Denhart/uniProject9-10/scripts/ff2correlation/README.md

# Files

## cst\_top, cst\_side
- Antenna: ilvonen2014design
- Top and side antenna
- Frequency: 870 MHz
- Expected correlation: 0.23578
