Denhart/uniProject9-10/rep/sec/analysis/requirements_spec.tex

\chapter{Requirements Specification}
\label{cha:reqspec}

\begin{aautop}
    The requirement specification sums up requirements, definitions, and guidelines for designing the antennas in the following chapters. Not all the requirement are hard requirements but guidelines for the design process.
\end{aautop}

\section{Functional Requirements}
\noindent
\begin{tabularx}{\linewidth}{|l|X|}
    \hline
    ID & Requirement \\
    \hline
    \freq{dualband} & The antenna system must consist of two single-feed dual-band antennas covering the bands described in Requirement~\sreqref{fbands}. \\
    \freq{updownlink} & Each antenna must cover both uplink and downlink at the same time for each required LTE band.\\
    % \freq{usereffect} & Must be able to re-tune any detuning due to user effects. \\ % ???? HAHA
    \freq{matching} & Must have a simple matching network, containing a variable capacitor for tuning inside the specified bands.\\
    \freq{wispry} & Must use a WiSpry WS1040 MEMS variable capacitor chip in the matching network.\\
    \hline
\end{tabularx}

\section{Specific Requirements}
\noindent 
\begin{tabularx}{\linewidth}{|l|l|X|}
    \hline
    ID & Specification & Requirement \\
    \hline
    \sreq{fbands} & Frequency bands\slash tunable range & \num{700}--\SI{960}{MHz}, \num{1710}--\SI{2170}{MHz}, \num{2300}--\SI{2400}{MHz}, \num{2550}--\SI{2650}{MHz} \\
    \sreq{bandwidthlow} & Minimum tunable bandwidth (\num{700}--\SI{960}{MHz}) & \SI{80}{MHz} (band 8) \\
    \sreq{bandwidthhigh} & Minimum tunable bandwidth (\num{1710}--\SI{2650}{MHz}) & \SI{720}{MHz} (band 15) \\
    \sreq{physdim} & Physical dimensions & External: $70\times140\times7$\,\si{mm\cubed}, PCB: $55\times120\times1.6$\,\si{mm\cubed} (FR-4)\\
    \sreq{copper} & Ground plane copper thickness & \SI{0.035}{mm} \\
    \sreq{retloss} & In-band return loss (impedance bandwidth) & $\text{RL} > \SI{6}{dB}$\\
    \sreq{correlation} & In-band correlation between antenna elements (correlation bandwidth) & $\rho_e < 0.5$\\
    \sreq{efficiency} & In-band total efficiency in free-space (efficiency bandwidth)  & $>\SI{50}{\%}$ \\
    \sreq{sar} & Maximum SAR & \SI{2}{W\per kg} averaged over \SI{10}{g} of tissue\\
    \sreq{tunable} & Tunable capacitor range (WS1040)& \SI{0.3}{pF} to \SI{2.9}{pF} in steps of \SI{0.2}{pF} (\SI{0.1}{pF} minimum)  \\
    \sreq{ltepower} & Reference power level  & \SI{23}{dBm} (\SI{0.2}{W})\\
    \hline
\end{tabularx}

\begin{aautail}
In this chapter, the functional and specific requirements for the antennas have been listed. The next chapter contains a test specification for the above specific requirements, describing how each requirement will be tested. 
\end{aautail}
