Denhart/uniProject9-10/pres/pres.tex

\documentclass[t]{beamer}
\usepackage[utf8]{inputenc}
\usepackage{soul}
\usepackage{tabularx}
\usepackage{booktabs}
\usepackage{tikz}
\usepackage{ulem}
\usepackage[per-mode = symbol,detect-all=true]{siunitx}
\sisetup{
    output-decimal-marker = {.},
    output-exponent-marker=\textsc{e}, 
    % round-mode=places,
    output-complex-root=j, 
    % unit-color=blue,
    % scientific-notation = engineering
}
\DeclareSIUnit[number-unit-product = \,]{\permil}{\textperthousand}
\usetheme{noergaard}
\newcommand{\hi}[1]{{\textcolor{themecolor}{\bfseries{#1}}}}

\definecolor{bb}{rgb}{0.0, 0.0, 1.0}
\definecolor{gg}{rgb}{0.0, 0.5, 0.0}
\definecolor{rr}{rgb}{1.0, 0.0, 0.0}
\definecolor{cc}{rgb}{0.0, 0.75, 0.75}
\definecolor{mm}{rgb}{0.75, 0.0, 0.75}
\definecolor{yy}{rgb}{0.75, 0.75, 0.0}
\definecolor{kk}{rgb}{0.0, 0.0, 0.0}

\newcounter{funcreqcnt}
\newcounter{specreqcnt}
\newcommand{\freq}[1]{ \refstepcounter{funcreqcnt}\label{#1} F\arabic{funcreqcnt} }
\newcommand{\sreq}[1]{ \refstepcounter{specreqcnt}\label{#1} S\arabic{specreqcnt} }
\newcommand{\freqref}[1]{F\ref{#1}}
\newcommand{\sreqref}[1]{S\ref{#1}}

\newcolumntype{R}{>{\raggedleft\arraybackslash}X}
\newcolumntype{C}{>{\centering\arraybackslash}X}
\newcolumntype{k}[1]{>{\centering\let\newline\\\arraybackslash\hspace{0pt}}p{#1}}

\title{\hi{Tunable Antennas for Handsets Supporting MIMO}}
\author{
    \hi{Group 951/1051}\\
    Henrik A.\ Vesterager\\
    Søren B.\ Nørgaard\\
    Lasse Thomsen\\[1em]
    Wireless Communication Systems\\
    Dept.\ of Electronic Systems, Aalborg University
}
\date{June 24, 2016}

\begin{document}
{%
    \setbeamertemplate{headline}{}
    \frame{\titlepage}
}

\begin{frame}
    \frametitle{Overview}
    \ \\
    \begin{minipage}{\linewidth}
        \tableofcontents
    \end{minipage}
\end{frame}

% \input{sec/exampleslide}
\input{sec/henrik}
\input{sec/soren}
\input{sec/lasse}
\end{document}
