Denhart/uniProject9-10/pres/sec/lasse.tex

\section[Ground Clearance]{Ground Clearance (Lasse)}
\def\legendfooter{\scriptsize{Upper: Top antenna. Lower: Side antenna. \textcolor{bb}{Monopole Sim}, \textcolor{gg}{Monopole Meas}, \textcolor{rr}{Triangle-Feed Meas}, Frequency in MHz.}}
\def\emptyline{\textcolor{white}{Empty}}

\begin{frame}[fragile]
  \frametitle{Ground Clearance}
  \begin{columns}[onlytextwidth,t]
    \column{0.49\linewidth}
      \begin{itemize}
      \item Triangle-Feed antenna measured on tuner PCB.
      \item More realizable antenna design in a mobile phone.
      \item One way of minimizing the antenna design.
      \item \SI{10}{mm} to \SI{5}{mm} ground clearance simulation.
      \item Minimized and simplified monopole design.
      \item Non-resonant design (monopole structure)
      \end{itemize}
    \column{0.49\linewidth}
    \begin{center}
      
    \end{center}
  \end{columns}
\end{frame}

\begin{frame}
  \frametitle{Ground Clearance}
    \begin{center}
      

    \end{center}
      \begin{itemize}
      \item Significant bandwidth and efficiency drop from \SI{5}{mm} to \SI{4}{mm}.
      \end{itemize}
\end{frame}

\section[Tuner PCB]{Tuner PCB (Lasse)}
\begin{frame}[fragile]
    \frametitle{Tuner PCB with MEMS Tuner}
\begin{center}
            
\end{center}
\begin{itemize}
\item Use previously made Tuner PCB -- save time.
\end{itemize}
\end{frame}

\begin{frame}
  \frametitle{Tuner PCB Results}
  \begin{itemize}
  \item Problems with detuning in the high frequencies.
  \end{itemize}
  \begin{center}
    
     \\
    
    
  \end{center}
\legendfooter
\end{frame}

\begin{frame}[fragile]
    \frametitle{Tuner PCB -- Modified Design}
    \begin{columns}[onlytextwidth,t]
        \column{0.49\linewidth}
          \begin{itemize}
          \item Adding a higher resonance to counteract the detuning.
          \item Two arms added in the available space. 
          \item Ground clearance \SI{2.5}{mm}.
          \end{itemize}
        \column{0.49\linewidth}
        \begin{center}
            
            
        \end{center}
        Tuner PCB with the modified monopole.
    \end{columns}
\end{frame}
\def\legendfooter{\scriptsize{Upper: Top antenna. Lower: Side antenna. \textcolor{bb}{Monopole Sim}, \textcolor{gg}{Monopole Meas}, Frequency in MHz.}}
\def\emptyline{\textcolor{white}{Empty}}

\begin{frame}
  \frametitle{Modified Monopole Results.}
\begin{center}
    
     \\
    
    
\end{center}
\vspace{-3mm}
      \begin{itemize}
      \item Final results -- something on the PCB radiating.
      \end{itemize}
\legendfooter
\end{frame}
\def\legendfooter{\scriptsize{Upper: Top antenna. Lower: Side antenna. \textcolor{bb}{Monopole without cap}, \textcolor{gg}{Monopole with cap}, Frequency in MHz.}}
\def\emptyline{\textcolor{white}{Empty}}

\begin{frame}
  \frametitle{Tuner PCB}
  \begin{itemize}
  \item With and without transmission line shunt capacitor.
  \item ``Finger sweep'' -- add capacitance.
  \end{itemize}
\begin{center}
    
\end{center}
\begin{itemize}
\item Increase in bandwidth in the high band.
\item Most significant for S11 but is also the case for S22. 
\end{itemize}
\legendfooter
\end{frame}

\section[Conclusion]{Conclusion (Lasse)}
\begin{frame}
  \begin{block}{Conclusion}
    \begin{itemize}
    \item \textbf{Three preliminary designs.}
    \item \textbf{Two designs on the tuner PCB.}
    \item Modified \SI{2.5}{mm} ground clearance design.
    \item Three \textbf{promising prototype results} (minimized antenna).
    \item Problems with the resonance in the higher frequencies.
    \item Low correlation on the high band -- \textbf{MIMO support in the high band}.
    \end{itemize}
  \end{block}
\vspace{-3mm}
  \begin{block}{Future Work}
    \begin{itemize}
    \item Simulation of Tuner PCB.
    \item New Tuner PCB.
    \item Modified monopole not necessary. 
    \item Different \SI{5}{mm} antenna designs.
    \item Two different designs on the PCB.
    \item Measure correlation -- simplified simulations.
    \end{itemize}
  \end{block}
\end{frame}

\begin{frame}
  \frametitle{Demo}
  \begin{columns}[onlytextwidth,t]
    \column{0.49\linewidth}
    \begin{itemize}
    \item S-Parameter sweep with the digitally MEMS tuner.
    \item Sweep the capacitance outside Satimo.
    \item UART over optical fiber to RFFE.
    \item No changes with the RFFE adaptor board + battery.
    \end{itemize}
    \column{0.49\linewidth}
        \begin{center}
            
        \end{center}
    \end{columns}
\end{frame}
