Denhart/uniProject9-10/pres/sec/soren.tex

\section[User Effects]{User Effects (Søren)}
% Illustration of setup/positions on slide 1
% One slide for each:
    % All S11 on slide 2 
    % All S22 on slide 3
    % All S21 on slide 4
    % All efficiency on slide 5
    % All correlation on slide 6
    % All SAR on slide 7 (only one figure)
% For each slide, three figures/subplot (for each design)
    % Blue (freespace[0]), alpha 0.5 (min(freespace))
    % Green (data[0]), alpha 0.5 (min(data))
    % Red (play[0]), alpha 0.5 (min(play))
    % Cyan (talk[0]), alpha 0.5 (min(talk))

\def\legendfooter{\scriptsize{(1) Monopole (2) Triangle-feed (3) Dual-feed. \textcolor{bb}{Free-space}, \textcolor{gg}{Data}, \textcolor{rr}{Play}, \textcolor{cc}{Talk}. Frequency in MHz.}}
\def\emptyline{\textcolor{white}{Empty}}
\begin{frame}
    \frametitle{User Effects}
    \begin{columns}[onlytextwidth,T]
        \column{0.49\linewidth}
        Color codes: \vspace{0pt}
        \begin{tabular}{m{1in}m{3in}}
            \rule{0in}{0.3in} & \textcolor{bb}{Free space}\\
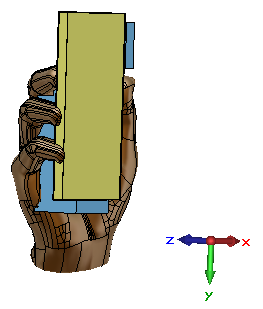
[picture p2: pres/img/soren/ue/usereff_onehand.PNG]
            \centering & \textcolor{gg}{Data mode} \\
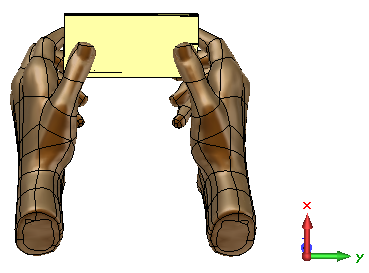
[picture p3: pres/img/soren/ue/usereff_twohand.PNG]
            \centering & \textcolor{rr}{Play mode} \\
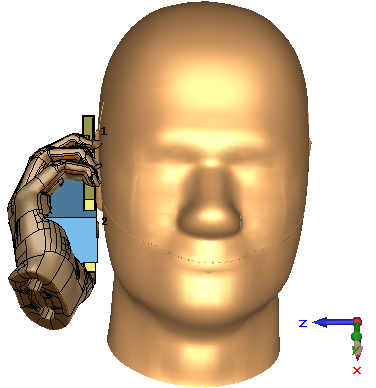
[picture p4: pres/img/soren/ue/usereff_headhand.PNG]
            \centering& \textcolor{cc}{Talk mode}\\
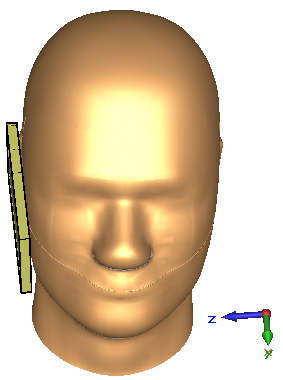
[picture p5: pres/img/soren/ue/usereff_sar.PNG]
            \centering     & SAR
        \end{tabular}

        \column{0.49\linewidth}
        Goal:
        \begin{itemize}
            \item Find the most stable design.
            \item Preserves bandwidth in use cases.
        \end{itemize}

        Plots:
        \begin{itemize}
            \item $S_{11}$, $S_{22}$, efficiency, correlation.
            \item All SAR $<\SI{2}{W/kg}$ @ \SI{10}{g} averaging.
            \item Isolation not shown. See report.
        \end{itemize}
        

        Spoiler:
        \begin{itemize}
            \item Design 2 (triangle-feed) is better.
        \end{itemize}
    \end{columns}
\end{frame}

\begin{frame}
    \frametitle{User Effects -- S11, minimum over tunable range}
    % \emptyline
    Design 2 is generally is better matched.
    \begin{center}
        \\
        \\
        
    \end{center}
    \legendfooter
\end{frame}

\begin{frame}
    \frametitle{User Effects -- S22, minimum over tunable range}
    % \emptyline
    Detuning. Design 2 is better matched.
    \begin{center}
        \\
        \\
        
    \end{center}
    \legendfooter
\end{frame}

\begin{frame}
    \frametitle{User Effects -- Total efficiency, minimum over tunable range (top)}
    % \emptyline
    \textit{Ideal components}. Talk mode is the worst.
    \begin{center}
        \\
        \\
        
    \end{center}
    \legendfooter
\end{frame}

\begin{frame}
    \frametitle{User Effects -- Total efficiency, minimum over tunable range (side)}
    \emptyline
    \begin{center}
        \\
        \\
        
    \end{center}
    \legendfooter
\end{frame}

\begin{frame}
    \frametitle{User Effects -- Correlation, minimum over tunable range (tuning top)}
    Highest: Free-space, talk mode. Winner $=$ design 3.
    % \emptyline
    \begin{center}
        \\
        \\
        
    \end{center}
    \legendfooter
\end{frame}

\begin{frame}
    \frametitle{User Effects -- Correlation, minimum over tunable range (tuning side)}
    Lower than tuning top.
    \emptyline
    \begin{center}
        \\
        \\
        
    \end{center}
    \legendfooter
\end{frame}

\begin{frame}
    \frametitle{User Effects -- Preliminary Conclusion}
    \begin{tabular}{m{0.4in}m{4in}}
        \rule{0pt}{0.9in} & 
            Design 2 -- triangle-feed
            \begin{itemize}
                \item Better efficiency and impedance bandwidth.
                \item High free-space correlation in low band. 
            \end{itemize}
            \\
        \rule{0pt}{0.9in} & 
            Design 3 -- dual-feed
            \begin{itemize}
                \item More fluctuating than design 2.
                \item Still good bandwidth/efficiency.
            \end{itemize}
            \\
        \rule{0pt}{0.9in} & 
            Design 1 -- monopole
            \begin{itemize}
                \item Very sensitive to user effects.
                \item Low efficiency and impedance bandwidth.
            \end{itemize}
    \end{tabular}
\end{frame}

\section[Prototypes]{Prototypes (Søren)}
\begin{frame}
    \frametitle{Prototypes}
    \begin{columns}[onlytextwidth,T]
        \vspace{0em}
        \column{0.49\linewidth}
        \begin{tabular}{m{0.3in}m{1.4in}}
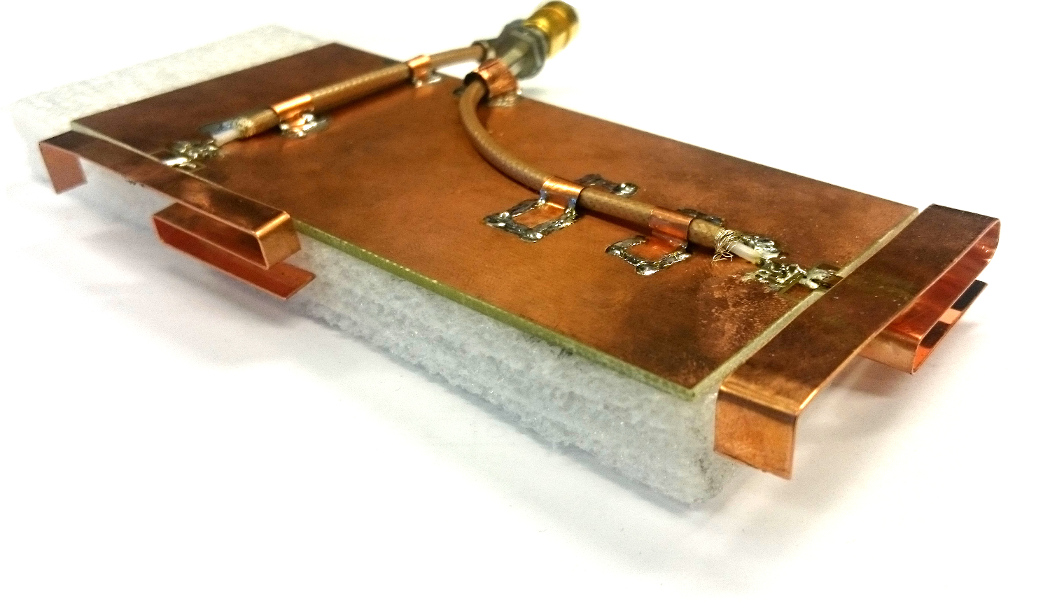
[picture p6: pres/img/soren/proto/design1.jpg]
             (1) & \\
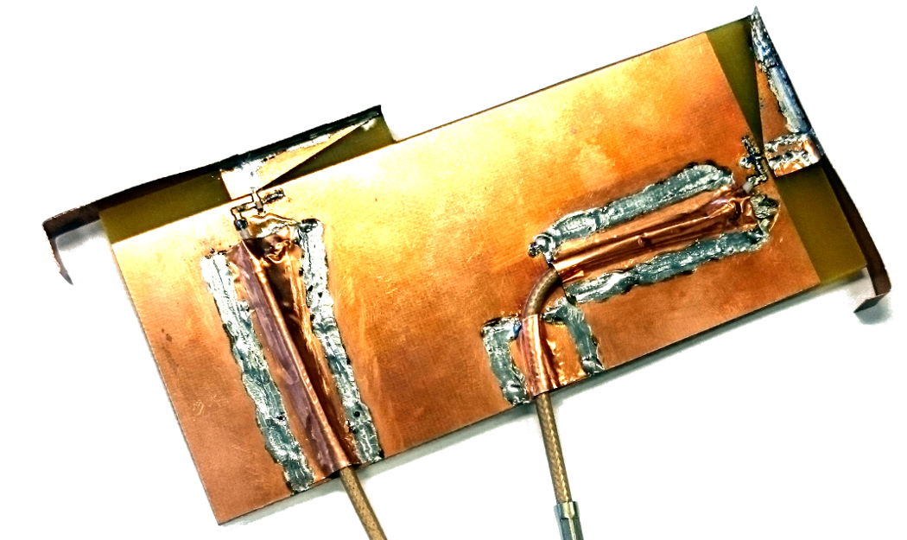
[picture p7: pres/img/soren/proto/design2.jpg]
             (2) & \\
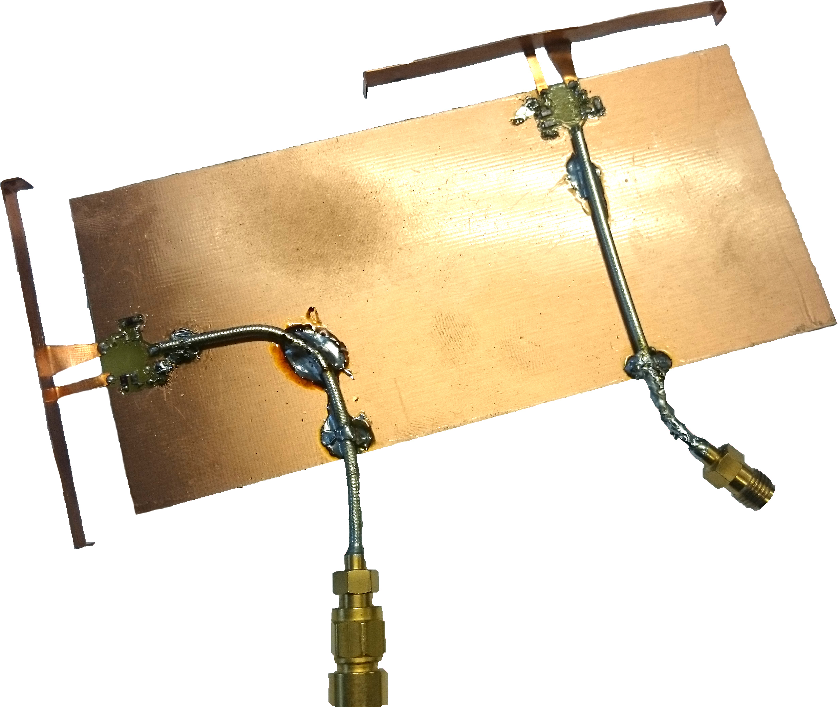
[picture p8: pres/img/soren/proto/design3.jpg]
             (3) & 
        \end{tabular}

        \column{0.49\linewidth}
        Goal:
        \begin{itemize}
            \item Find most realizable design.
            \item Verify simulation results -- useful design in real life?
        \end{itemize}

        Plots:
        \begin{itemize}
            \item $S_{11}$, $S_{22}$, efficiency.
            \item Isolation not shown. See report.
        \end{itemize}

        Spoiler:
        \begin{itemize}
            \item Design 2 (triangle-feed) is better.
        \end{itemize}
    \end{columns}
\end{frame}

\def\legendfooter{\scriptsize{Upper: Top antenna. Lower: Side antenna. Frequency in MHz.}}
\begin{frame}
    \frametitle{Prototype 1 -- Monopole}
    High band moves a lot during tuning.
    % \emptyline
    \begin{center}
        
        \\
        
        
    \end{center}
    \legendfooter
\end{frame}

\begin{frame}
    \frametitle{Prototype 2 -- Triangle-feed}
    \textcolor{gg}{High bandwidth!} High band stable over multiple capacitances.
    % \emptyline
    \begin{center}
        
        \\
        
        
    \end{center}
    \legendfooter
\end{frame}

\begin{frame}
    \frametitle{Prototype 3 -- Dual-feed}
    OK efficiency. Side antenna -- good but not tunable.
    % \emptyline
    \begin{center}
        
        \\
        
        
    \end{center}
    \legendfooter
\end{frame}

\begin{frame}
    \frametitle{Prototypes -- Preliminary Conclusion}
    \begin{tabular}{m{0.4in}m{4in}}
        \rule{0pt}{0.9in} & 
            Design 2 -- triangle-feed.
            \begin{itemize}
                \item Covers all bands at $C_{\text{low}}$.
                \item Preserves higher efficiency when tuned.
                \item \textit{Moved to tuner PCB}.
            \end{itemize}
            \\
        \rule{0pt}{0.9in} & 
            Design 3 -- dual-feed
            \begin{itemize}
                \item Top antenna good in most bands.
                \item Side antenna not tunable but good.
                \item Matching network $\neq$ tuner PCB.
            \end{itemize}
            \\
        \rule{0pt}{0.9in} & 
            Design 1 -- monopole
            \begin{itemize}
                \item Covers low bands OK.
                \item Low efficiency when tuned.
            \end{itemize}
    \end{tabular}
\end{frame}
