Denhart/uniProject9-10/rep/set/frontpage.tex

\thispagestyle{empty}
\newgeometry{top=1.7cm, bottom=1.7cm, left=1.7cm, right=1.7cm}
\noindent%
\begin{tabular}{@{}p{\textwidth}@{}}
    \rule{\linewidth}{2mm}\vspace{1.5cm}
    \vspace*{-15mm}
    \begin{flushleft}
        \linespread{0.7}
        \fontsize{40}{56}
        \usefont{T1}{phv}{b}{}
        \selectfont
        Tunable Antennas for Handsets Supporting MIMO
    \end{flushleft} \\[5mm] 
    \raggedright{
        \fontsize{24}{36}\usefont{T1}{phv}{}{}\selectfont
        June 2016\\ \vspace*{1mm}
    }
    \rule{\linewidth}{.7mm}
\end{tabular}
\vspace{1cm} %Removed to make it one page
\begin{flushleft}
  {\LARGE\usefont{T1}{phv}{b}{}\selectfont
      Group 951/1051%Insert your group name or real names here
  }\\
  \vspace{0.2cm}
  {\large\usefont{T1}{phv}{}{}\selectfont
      Master Thesis %Insert document type (e.g., Project Report)
  }
\end{flushleft}
\begin{center}
    % \includegraphics[scale=.7]{img/frontpage}
\end{center}
\vfill
\begin{flushleft}\usefont{T1}{phv}{}{}\selectfont
  Aalborg University\\
  Department of Electronic Systems\\
  Wireless Communication Systems\\
  Fredrik Bajers Vej 7\\
  DK-9220 Aalborg
\end{flushleft}
\restoregeometry
