Denhart/uniProject9-10/rep/sec/tech_sol/sol_3_usereff.tex

\section{Dual-Feed Antenna}
In this section, the results from Section~\ref{sec:tech_sol_ant3} will be repeated, having the phone in data mode, play mode, and talk mode. Furthermore, the maximum SAR value, recorded in the users head, will be simulated. The antenna positions, for each use case, are shown in Figure~\ref{fig:ant3_positions}.

\begin{figure}[htbp]
    \centering
    \begin{subfigure}[b]{0.24\linewidth}
        \centering
        
        \caption{Data mode.}
    \end{subfigure}
    \begin{subfigure}[b]{0.24\linewidth}
        \centering
        
        \caption{Play mode.}
    \end{subfigure}
    \begin{subfigure}[b]{0.24\linewidth}
        \centering
        
        \caption{Talk mode.}
    \end{subfigure}
    \begin{subfigure}[b]{0.24\linewidth}
        \centering
        
        \caption{SAR.}
    \end{subfigure}
    \caption{Antenna position for each user effect simulation.}
    \label{fig:ant3_positions}
\end{figure}

\FloatBarrier
\subsection{Data Mode}
%%
Figure~\ref{fig:ant3_sparam_data} shows the $S$-parameters with the tunable capacitors set to their maxima. As such, both the top and side antennas have been tuned down to the lowest possible frequency. It is seen that the top antenna covers most of the band from \SI{700}{MHz} to \SI{960}{MHz} with a return loss above \SI{6}{dB}. The side antenna is, however, very narrowband and must be tuned in order to cover all the low bands. It is also seen that the side antenna does not cover the entire high band when tuned down to the lowest capacitor value. 

%%
The $S$-parameters, when sweeping the tunable capacitors, are shown in Figure~\ref{fig:ant3_sparam_sweep_data}. The maximum impedance-bandwidths are summed up in Table~\ref{tab:bw_sol3data}. From this, it is again clear that only the top antenna is able to cover the high end of the low band. Both antennas are able to cover the entire high band at \SI{6}{dB} return loss, except for a drop of \SI{1}{dB} at \SI{2600}{MHz} to \SI{2650}{MHz} for the top antenna.

%%
The correlation between the antennas, when sweeping the tunable capacitors, are shown in Figure~\ref{fig:corr_sol3_data}. The correlation is, for frequencies above \SI{700}{MHz}, below 0.4 when sweeping the top and side antenna. For the high band, the correlation is significantly lower, which is also to be expected. The correlation has dropped a lot from the free-space simulation in Figure~\ref{fig:corr_sol3}.

%%
The efficiencies for each antenna, when sweeping the tuning capacitors, are shown in Figure~\ref{fig:eff_sol3data}. It is seen that the efficiency, generally, has decreased from the free-space simulation in Chapter~\ref{cha:nousersim}. At \SI{-3}{dB} efficiency, there is no bandwidth left. At \SI{-6}{dB} all bands are covered. The efficiency in the high band is generally higher than in the low band.

\begin{figure}[htbp]
    \centering
    
    \caption{The antenna in data mode. $S$-parameters with both tuning capacitors fixed at \SI{2.9}{pF}.}
    \label{fig:ant3_sparam_data}
\end{figure}

\begin{table}[htbp]
    \centering
    \begin{tabular}{|l|l|r|r|r|}
        \hline
        Antenna & Band & Start [MHz] & Stop [MHz] & Bandwidth [MHz] \\
        \hline
        Top     & Low  & 713         & 963       & 250 \\
        Side    & Low  & 717         & 765        & 48  \\
        \hline
        Top     & High & 1635         & 2537       & 902 \\
        Side    & High & 1430        & 2582       & 1152 \\
        \hline
    \end{tabular}
    \caption{The antenna in data mode. Maximum bandwidth obtained in the low and high band for the top and the side antenna, respectively.}
    \label{tab:bw_sol3data}
\end{table}

\begin{figure}[htbp]
   \begin{subfigure}[b]{0.49\linewidth}
        \centering
        
        \caption{$S_{11}$, sweeping $C_{l3}$ and fixing $s\_C_{h1}$.}
    \end{subfigure}
    \hfill
    \begin{subfigure}[b]{0.49\linewidth}
        \centering
        
        \caption{$S_{22}$, sweeping $C_{l3}$ and fixing $s\_C_{h1}$.}
    \end{subfigure}
    \\
    \begin{subfigure}[b]{0.49\linewidth}
        \centering
        
        \caption{$S_{21}$, sweeping $C_{l3}$ and fixing $s\_C_{h1}$.}
    \end{subfigure}
    \hfill
    \begin{subfigure}[b]{0.49\linewidth}
        \centering
        
        \caption{$S_{21}$, sweeping $s\_C_{h1}$ and fixing $C_{l3}$.}
    \end{subfigure}
    \caption{The antenna in data mode. $S$-parameter sweep for tuning the shunt capacitor of each antenna, $C_{l3}$ and $s\_C_{h1}$ for port 1 and 2, respectively. Port 1 is the top antenna and port 2 is the side antenna.}
    \label{fig:ant3_sparam_sweep_data}
\end{figure}

% Correlation
\begin{figure}[htbp]
    \centering
    \begin{subfigure}{0.49\linewidth}
        
        \caption{Sweeping $C_{l3}$ and fixing $s\_C_{h1}$.}
    \end{subfigure}
    \hfill
    \begin{subfigure}{0.49\linewidth}
        
        \caption{Sweeping $s\_C_{h1}$ and fixing $C_{l3}$.}
    \end{subfigure}
    \caption{The antenna in data mode. Correlation between antennas when sweeping the tuning capacitors. Here, $C_{l3}$ and $s\_C_{h1}$ are the tuning capacitor for the top and side antenna, respectively.}
    \label{fig:corr_sol3_data}
\end{figure}

% Efficiency
\begin{figure}[htbp]
    \centering
    \begin{subfigure}{0.49\linewidth}
        \centering
        
        \caption{Top antenna. Sweeping $C_{l3}$, fixing $s\_C_{h1}$.}
    \end{subfigure}
    \hfill
    \begin{subfigure}{0.49\linewidth}
        \centering
        
        \caption{Side antenna. Sweeping $s\_C_{h1}$, fixing $C_{l3}$.}
    \end{subfigure}
    \caption{The antenna in data mode. Efficiency for each antenna when sweeping the tuning capacitors. Here, $C_{l3}$ and $s\_C_{h1}$ are the tuning capacitor for the top and side antenna, respectively.}
    \label{fig:eff_sol3data}
\end{figure}

\FloatBarrier
\subsection{Play Mode}
%%
Figure~\ref{fig:ant3_sparam_play} shows the $S$-parameters with the tunable capacitors set to their maxima. As such, both the top and side antennas have been tuned down to the lowest possible frequency. It is seen that the top antenna covers most of the band from \SI{700}{MHz} to \SI{960}{MHz} with a return loss above \SI{4}{dB}. The side antenna is, however, very narrowband, and must be tuned in order to cover all the low bands. It is also seen that the side antenna does not cover the entire high band when tuned down to the lowest. 

%%
The $S$-parameters, when sweeping the tunable capacitors, are shown in Figure~\ref{fig:ant3_sparam_sweep_play}. The maximum impedance bandwidths are summed up in Table~\ref{tab:bw_sol3data}. From this, it is again clear that only the top antenna is able to cover the high end of the low band. Both antennas are be able to cover the entire high band at \SI{4}{dB} return loss.

%%
The correlation between the antennas, when sweeping the tunable capacitors, are shown in Figure~\ref{fig:corr_sol3_play}. The correlation is, for frequencies above \SI{700}{MHz}, below 0.4 when sweeping the top and side antenna. For the high band, the correlation is significantly lower. Again, the correlation has dropped a lot from the free-space simulation in Figure~\ref{fig:corr_sol3}.

%%
The efficiencies for each antenna, when sweeping the tuning capacitors, are shown in Figure~\ref{fig:eff_sol3play}. It is seen that the efficiency, generally, has decreased from the free-space simulation in Chapter~\ref{cha:nousersim} and is also lower than the data mode. At \SI{-3}{dB} efficiency, there is no bandwidth left. At \SI{-6}{dB} most of the bands are covered.

\begin{figure}[htbp]
    \centering
    
    \caption{The antenna in play mode. $S$-parameters with both tuning capacitors fixed at \SI{2.9}{pF}.}
    \label{fig:ant3_sparam_play}
\end{figure}

\begin{table}[htbp]
    \centering
    \begin{tabular}{|l|l|r|r|r|}
        \hline
        Antenna & Band & Start [MHz] & Stop [MHz] & Bandwidth [MHz] \\
        \hline
        Top     & Low  & 690         & 791        & 101  \\
        Side    & Low  & 780         & 803        & 23   \\
        \hline
        Top     & High & 1676        & 2579       & 903 \\
        Side    & High & 1341        & 1919       & 578 \\
        \hline
    \end{tabular}
    \caption{The antenna in play mode. Maximum bandwidth obtained in the low and high band for the top and the side antenna, respectively. The bandwidth for the antennas high band is ignoring the rise above \SI{-6}{dB} in the middle of the band.}
    \label{tab:bw_sol3play}
\end{table}

\begin{figure}[htbp]
   \begin{subfigure}[b]{0.49\linewidth}
        \centering
        
        \caption{$S_{11}$, sweeping $C_{l3}$ and fixing $s\_C_{h1}$.}
    \end{subfigure}
    \hfill
    \begin{subfigure}[b]{0.49\linewidth}
        \centering
        
        \caption{$S_{22}$, sweeping $C_{l3}$ and fixing $s\_C_{h1}$.}
    \end{subfigure}
    \\
    \begin{subfigure}[b]{0.49\linewidth}
        \centering
        
        \caption{$S_{21}$, sweeping $C_{l3}$ and fixing $s\_C_{h1}$.}
    \end{subfigure}
    \hfill
    \begin{subfigure}[b]{0.49\linewidth}
        \centering
        
        \caption{$S_{21}$, sweeping $s\_C_{h1}$ and fixing $C_{l3}$.}
    \end{subfigure}
    \caption{The antenna in play mode. Parameter sweep for tuning the shunt capacitor of each antenna, $C_{l3}$ and $s\_C_{h1}$ for port 1 and 2, respectively. Port 1 is the top antenna and port 2 is the side antenna.}
    \label{fig:ant3_sparam_sweep_play}
\end{figure}

% Correlation
\begin{figure}[htbp]
    \centering
    \begin{subfigure}{0.49\linewidth}
        
        \caption{Sweeping $C_{l3}$ and fixing $s\_C_{h1}$.}
    \end{subfigure}
    \hfill
    \begin{subfigure}{0.49\linewidth}
        
        \caption{Sweeping $s\_C_{h1}$ and fixing $C_{l3}$.}
    \end{subfigure}
    \caption{The antenna in play mode. Correlation between antennas when sweeping tuning the capacitors. Here, $C_{l3}$ and $s\_C_{h1}$ are the tuning capacitor for the top and side antenna, respectively.}
    \label{fig:corr_sol3_play}
\end{figure}

% Efficiency
\begin{figure}[htbp]
    \centering
    \begin{subfigure}{0.49\linewidth}
        \centering
        
        \caption{Top antenna. Sweeping $C_{l3}$, fixing $s\_C_{h1}$.}
    \end{subfigure}
    \hfill
    \begin{subfigure}{0.49\linewidth}
        \centering
        
        \caption{Side antenna. Sweeping $s\_C_{h1}$, fixing $C_{l3}$.}
    \end{subfigure}
    \caption{The antenna in play mode. Efficiency for each antenna when sweeping the tuning capacitors. Here, $C_{l3}$ and $s\_C_{h1}$ are the tuning capacitor for the top and side antenna, respectively.}
    \label{fig:eff_sol3play}
\end{figure}

\FloatBarrier
\subsection{Talk Mode}
%%
Figure~\ref{fig:ant3_sparam_talk} shows the $S$-parameters with the tunable capacitors set to their maxima. As such, both the top and side antennas have been tuned down to the lowest possible frequency. It is seen that the top antenna covers most of the band from \SI{700}{MHz} to \SI{960}{MHz}, with a return loss above \SI{6}{dB}. The side antenna is, however, very narrowband, and must be tuned in order to cover all the low bands. It is also seen that the side antenna does not cover the entire high band when tuned down to the lowest. 

%%
The $S$-parameters, when sweeping the tunable capacitors, are shown in Figure~\ref{fig:ant3_sparam_sweep_play}. The maximum impedance-bandwidths are summed up in Table~\ref{tab:bw_sol3data}. From this it is again clear that only the top antenna is able to cover the high end of the low band. Both antennas are able to cover the entire high band at \SI{6}{dB} return loss, except for a small drop of \SI{1}{dB} from \SI{2600}{MHz} to \SI{2650}{MHz}.

%%
The correlation between the antennas, when sweeping the tunable capacitors, are shown in Figure~\ref{fig:corr_sol3_play}. The correlation is, for frequencies above \SI{700}{MHz}, below 0.7 when sweeping the top and side antenna. For the high band, the correlation is significantly lower. Again, the correlation has dropped a lot from the free-space simulation in Figure~\ref{fig:corr_sol3}.

%%
The efficiencies for each antenna, when sweeping the tuning capacitors, are shown in Figure~\ref{fig:eff_sol3talk}. It is seen that the efficiency, generally, has decreased from the free-space simulation in Chapter~\ref{cha:nousersim} and is also lower than the data mode. At \SI{-3}{dB} efficiency, there is no bandwidth left. At \SI{-9}{dB} most of the bands are covered.

\begin{figure}[htbp]
    \centering
    
    \caption{The antenna in talk mode. $S$-parameters with both tuning capacitors fixed at \SI{2.9}{pF}.}
    \label{fig:ant3_sparam_talk}
\end{figure}

\begin{table}[htbp]
    \centering
    \begin{tabular}{|l|l|r|r|r|}
        \hline
        Antenna & Band & Start [MHz] & Stop [MHz] & Bandwidth [MHz] \\
        \hline
        Top     & Low  & 674         & 1055       & 381 \\
        Side    & Low  & 576         & 617        & 41   \\
        \hline
        Top     & High & 1658         & 2243       & 585 \\
        Side    & High & 1612        & 2784       & 1172 \\
        \hline
    \end{tabular}
    \caption{The antenna in talk mode. Maximum bandwidth obtained in the low and high band for the top and the side antenna, respectively. It is, again, seen that both the low and high band are covered at the same time for the top antenna.}
    \label{tab:bw_sol3talk}
\end{table}

\begin{figure}[htbp]
   \begin{subfigure}[b]{0.49\linewidth}
        \centering
        
        \caption{$S_{11}$, sweeping $C_{l3}$ and fixing $s\_C_{h1}$.}
    \end{subfigure}
    \hfill
    \begin{subfigure}[b]{0.49\linewidth}
        \centering
        
        \caption{$S_{22}$, sweeping $C_{l3}$ and fixing $s\_C_{h1}$.}
    \end{subfigure}
    \\
    \begin{subfigure}[b]{0.49\linewidth}
        \centering
        
        \caption{$S_{21}$, sweeping $C_{l3}$ and fixing $s\_C_{h1}$.}
    \end{subfigure}
    \hfill
    \begin{subfigure}[b]{0.49\linewidth}
        \centering
        
        \caption{$S_{21}$, sweeping $s\_C_{h1}$ and fixing $C_{l3}$.}
    \end{subfigure}
    \caption{The antenna in talk mode. Parameter sweep for tuning the shunt capacitor of each antenna, $C_{l3}$ and $s\_C_{h1}$ for port 1 and 2, respectively. Port 1 is the top antenna and port 2 is the side antenna.}
    \label{fig:ant3_sparam_sweep_talk}
\end{figure}

% Correlation
\begin{figure}[htbp]
    \centering
    \begin{subfigure}{0.49\linewidth}
        
        \caption{Sweeping $C_{l3}$ and fixing $s\_C_{h1}$.}
    \end{subfigure}
    \hfill
    \begin{subfigure}{0.49\linewidth}
        
        \caption{Sweeping $s\_C_{h1}$ and fixing $C_{l3}$.}
    \end{subfigure}
    \caption{The antenna in talk mode. Correlation between antennas when sweeping the tuning capacitors. Here, $C_{l3}$ and $s\_C_{h1}$ are the tuning capacitor for the top and side antenna, respectively.}
    \label{fig:corr_sol3_talk}
\end{figure}

% Efficiency
\begin{figure}[htbp]
    \centering
    \begin{subfigure}{0.49\linewidth}
        \centering
        
        \caption{Top antenna. Sweeping $C_{l3}$, fixing $s\_C_{h1}$.}
    \end{subfigure}
    \hfill
    \begin{subfigure}{0.49\linewidth}
        \centering
        
        \caption{Side antenna. Sweeping $s\_C_{h1}$, fixing $C_{l3}$.}
    \end{subfigure}
    \caption{The antenna in talk mode. Efficiency for each antenna when sweeping the tuning capacitors. Here, $C_{l3}$ and $s\_C_{h1}$ are the tuning capacitor for the top and side antenna, respectively.}
    \label{fig:eff_sol3talk}
\end{figure}

\FloatBarrier
\subsection{SAR}
%%
The result from the SAR simulation is shown in Figure~\ref{fig:ant3_sar_sim}. It is seen, that the maximum SAR value is around \SI{1.2}{W\per kg}, which is within the maximum of \SI{2}{W\per kg} for the side antenna. A possible way to improve this may be to simulate the phone with a screen, which will be located between the antenna and the head. This may reflect some of the radiated power away from the user, lowering the maximum SAR. However, since it already complies with the requirements, this has not been done. 

\begin{figure}[htbp]
    \centering
    
    \caption{SAR simulation of the antenna.}
    \label{fig:ant3_sar_sim}
\end{figure}
