Denhart/uniProject9-10/rep/sec/tech_sol/intro_usereff.tex

\chapter{User Effect Simulations}
\label{cha:usereff}
In this chapter, the antennas from Chapter~\ref{cha:nousersim} are simulated in use.
The four simulation models are shown in Figure~\ref{fig:usereff_intro}. The SAR simulation is solely used to check the requirement for maximum SAR seen in the requirement specification, Chapter~\ref{cha:reqspec}. For the other three simulations, the same types of results as in Chapter~\ref{cha:nousersim} are shown to see how the antennas perform when the phones are in use.

The simulations are done with a phone case in order to align the phone with the blue spacer as seen in Figure~\ref{fig:usereff_intro}. The case used is made of thin \SI{0.5}{mm} plastic and is customized to fit each antenna design. Furthermore, to make the SAR simulations more accurate and realistic, a screen model made of PEC is used.

The material types and constants can be seen in Table~\ref{tab:cst_material}. The head, hand, and spacer is made accordingly to the CTIA test plan \cite{cita2015}. Second order permittivity dispersion model fits have been used for the head and hand models to gain more accurate results.

\begin{table}
  \centering
  \begin{tabular}{|l|l|r|r|}
    \hline
    Type & Material & Permeability [$\mu$] & Permittivity [$\epsilon$] \\
    \hline
    Case      & Plastic  & 1    & 3       \\
    Spacer    & Vacuum   & 1    & 1       \\
    Hand      & Shell and fluid   & 1    & 2nd order dispersion model    \\
    Head      & Shell    & 1    & 3.7     \\
    Head      & Fluid    & 1    & 2nd order dispersion model     \\ 
    \hline
  \end{tabular}
  \caption{Material types and constants used in the user effect simulations.}
  \label{tab:cst_material}
\end{table}

The below settings were used when simulating the user effect:
\begin{description}
\item[Accuracy] \SI{-60}{dB}.
\item[One hand (data mode)] Approximately \num{7500000} mesh cells.
\item[Two hands (play mode)] Approximately \num{15000000} mesh cells.
\item[Head and hand (talk mode, SAR)] Approximately \num{15000000} mesh cells.
\end{description}

\begin{figure}[htbp]
  \centering
  \begin{subfigure}[b]{0.24\linewidth}
        \centering
        
        \caption{Data mode.}
        \label{fig:usereff_onehand}
    \end{subfigure}
    \hfill
    \begin{subfigure}[b]{0.24\linewidth}
        \centering
        
        \caption{Play mode.}
        \label{fig:usereff_twohand}
    \end{subfigure}
    \hfill
    \begin{subfigure}[b]{0.24\linewidth}
        \centering
        
        \caption{Talk mode.}
        \label{fig:usereff_headhand}
    \end{subfigure}
    \hfill
    \begin{subfigure}[b]{0.24\linewidth}
        \centering
        
        \caption{SAR simulation.}
        \label{fig:usereff_sar}
    \end{subfigure}
    \caption{User effect simulation modes.}
    \label{fig:usereff_intro}
\end{figure}
