Denhart/uniProject9-10/rep/sec/analysis/intro.tex

\chapter{Problem Analysis}
\label{cha:problem_analysis}

\begin{aautop}
This chapter covers all the theory and background knowledge needed in order to begin development, simulations, and measurements of a technical solution. This includes the basic antenna parameters, the background of LTE, and the measurement techniques used throughout the report.
\end{aautop}
