Denhart/uniProject9-10/rep/set/macros.tex

\newenvironment{aautop}{\noindent\ignorespaces}{\vskip 1em}
\newenvironment{aautail}{\vskip 1em\noindent\ignorespaces}{}
\newcommand{\cdref}[1] {
    \begin{flushleft}
        \begin{tabular}{ll}
            \hspace{1em} & \texttt{#1}
        \end{tabular}
    \end{flushleft}
}
\newcommand{\arbejdsbladDato}[1] {
      \begin{flushright}\itshape #1\end{flushright}
}
\newcommand{\hex}[1] {
      \texttt{#1}
}
\def\itoc{I$^2$C\xspace}
\newcommand{\real}[1]{\text{Re}\left\{#1\right\}}
\newcommand{\imag}[1]{\text{Im}\left\{#1\right\}}
\DeclareMathOperator{\sgn}{sgn}
\DeclareMathOperator{\diag}{diag}
\DeclareMathOperator{\sort}{sort}
\DeclareMathOperator{\trace}{trace}
\newcommand{\intsphere}[1]{\int_0^{2\pi}\int_0^{\pi} #1 \ \sin{\theta}d\theta d\phi}

\newcounter{funcreqcnt}
\newcounter{specreqcnt}
\newcommand{\freq}[1]{ \refstepcounter{funcreqcnt}\label{#1} F\arabic{funcreqcnt} }
\newcommand{\sreq}[1]{ \refstepcounter{specreqcnt}\label{#1} S\arabic{specreqcnt} }
\newcommand{\freqref}[1]{F\ref{#1}}
\newcommand{\sreqref}[1]{S\ref{#1}}

\newcommand\wherelabel[1]{\hspace{\labelsep}#1 $=$}
\newenvironment{where}{%
    \let\descriptionlabel\wherelabel
    \description
}{%
    \enddescription
}
\newcommand{\tabitem}{~~\llap{\textbullet}~~}

\makeatletter
\renewcommand*\FXLayoutInline[3]{%
  {\@fxuseface{inline}\ignorespaces(Fixme: #2)}}
\makeatother
