Denhart/uniProject9-10/rep/img/optical_rffe/avr_rffe_reg1_0x00.pdf

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

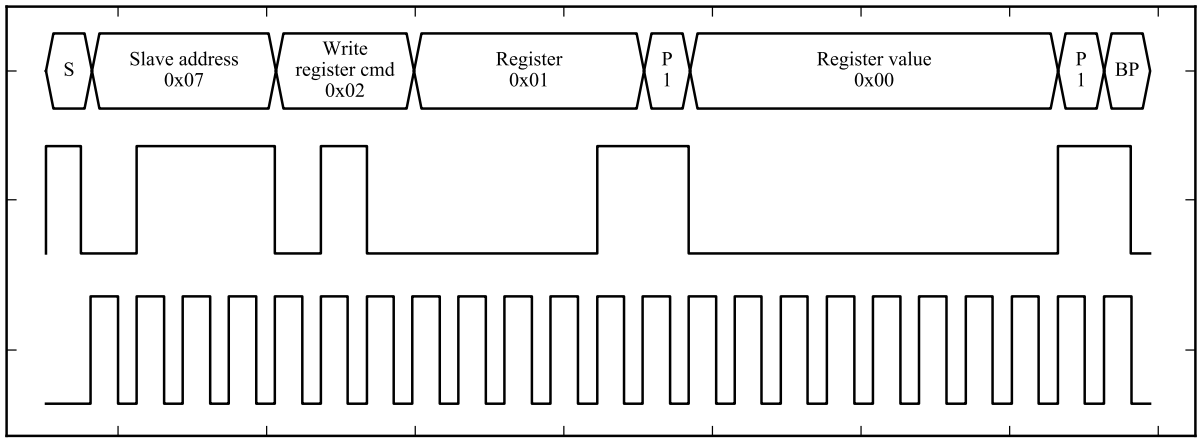
[picture p19: figure]
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
