Denhart/uniProject9-10/rep/img/tech_sol/schematic_tuning_1.pdf

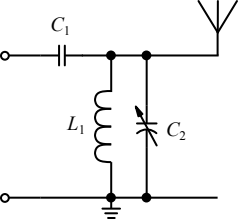
[picture p20: figure]
