Denhart/uniProject9-10/mockups/007-lasse_double/2016-05-11-opticalboard_vs_no-opticalboard/noboard_nobatteryCh1.csv

# Version 1.00
#
freq[Hz] | Trc1_S11[dB] | Trc2_S22[dB] | Trc3_S21[dB]
6.000000000000000E+008 | -5.676274762926720E-001 | -2.221541578074686E-001 | -5.663700221263444E+001
6.120000000000000E+008 | -5.938491435242994E-001 | -2.337869826703641E-001 | -5.459441549953638E+001
6.240000000000000E+008 | -6.436469286621249E-001 | -2.413377275542251E-001 | -5.221621966385958E+001
6.360000000000000E+008 | -6.854956444746047E-001 | -2.454404174797447E-001 | -5.015734538834095E+001
6.480000000000000E+008 | -7.419401600700164E-001 | -2.487010008177607E-001 | -4.825774788088569E+001
6.600000000000000E+008 | -8.356303556773854E-001 | -2.391977413424573E-001 | -4.658996120862339E+001
6.720000000000000E+008 | -9.424207751553418E-001 | -2.565288150100087E-001 | -4.483377074192958E+001
6.840000000000000E+008 | -1.078489936183795E+000 | -2.696302494961887E-001 | -4.324902871753457E+001
6.960000000000000E+008 | -1.244155873525221E+000 | -2.894208803062366E-001 | -4.137304162365785E+001
7.080000000000000E+008 | -1.476865458749156E+000 | -3.094951056793218E-001 | -3.973709112263938E+001
7.200000000000000E+008 | -1.687661352427678E+000 | -3.206704117845254E-001 | -3.863430173875037E+001
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
