Denhart/uniProject9-10/mockups/007-lasse_double/2016-05-11-opticalboard_vs_no-opticalboard/withboard_nobatteryCh1.csv

# Version 1.00
#
freq[Hz] | Trc1_S11[dB] | Trc2_S22[dB] | Trc3_S21[dB]
6.000000000000000E+008 | -5.637205934516452E-001 | -2.225091058440905E-001 | -5.716841007333721E+001
6.120000000000000E+008 | -5.891987504215792E-001 | -2.319401580826534E-001 | -5.450608884093070E+001
6.240000000000000E+008 | -6.358934001689065E-001 | -2.401791475805601E-001 | -5.261481517922483E+001
6.360000000000000E+008 | -6.718739038653318E-001 | -2.416178373408731E-001 | -5.075449158801595E+001
6.480000000000000E+008 | -7.289430433213070E-001 | -2.471018902293821E-001 | -4.898155150814659E+001
6.600000000000000E+008 | -8.268024853846187E-001 | -2.387264789693665E-001 | -4.749896541805047E+001
6.720000000000000E+008 | -9.315200110954114E-001 | -2.550924136731791E-001 | -4.569558748086705E+001
6.840000000000000E+008 | -1.054684353128408E+000 | -2.683357019357793E-001 | -4.411872411179789E+001
6.960000000000000E+008 | -1.197060319912824E+000 | -2.860039053506316E-001 | -4.233596735689712E+001
7.080000000000000E+008 | -1.393123709874043E+000 | -3.062817608026377E-001 | -4.079079015829538E+001
7.200000000000000E+008 | -1.586805161297024E+000 | -3.163312964483612E-001 | -3.943977625662208E+001
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
