Denhart/uniProject9-10/mockups/007-lasse_double/2016-05-11-opticalboard_vs_no-opticalboard/withboard_withbatteryCh1.csv

# Version 1.00
#
freq[Hz] | Trc1_S11[dB] | Trc2_S22[dB] | Trc3_S21[dB]
6.000000000000000E+008 | -5.647467027510257E-001 | -2.200808378858496E-001 | -5.690343425940975E+001
6.120000000000000E+008 | -5.875242810722945E-001 | -2.302256060784566E-001 | -5.481837637351892E+001
6.240000000000000E+008 | -6.386279821613083E-001 | -2.412264592565428E-001 | -5.290691222023882E+001
6.360000000000000E+008 | -6.762328876785128E-001 | -2.421832716984329E-001 | -5.100368799917499E+001
6.480000000000000E+008 | -7.357080290840427E-001 | -2.472350418311443E-001 | -4.932130559065323E+001
6.600000000000000E+008 | -8.242565381962472E-001 | -2.377612268521188E-001 | -4.825479048051005E+001
6.720000000000000E+008 | -9.120203830628529E-001 | -2.546584339474182E-001 | -4.638380706894497E+001
6.840000000000000E+008 | -1.017587694609620E+000 | -2.681632109787544E-001 | -4.491147821826233E+001
6.960000000000000E+008 | -1.168311190162466E+000 | -2.836142368431862E-001 | -4.296166093620102E+001
7.080000000000000E+008 | -1.378940453549774E+000 | -3.054846481063157E-001 | -4.108562906293737E+001
7.200000000000000E+008 | -1.583887573509752E+000 | -3.153490590007334E-001 | -3.986795008506947E+001
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
