Denhart/uniProject9-10/hw/meas/soren/uart_over_optical.csv

x-axis | 1 | 2
second | Volt | Volt
-2.500000E-03 | +3.547738634E+00 | +5.069226287E+00
-2.497500E-03 | +3.547738634E+00 | +4.988824278E+00
-2.495000E-03 | +3.542713508E+00 | +4.988824278E+00
-2.492500E-03 | +3.467336625E+00 | +4.988824278E+00
-2.490000E-03 | +3.462311499E+00 | +5.064201162E+00
-2.487500E-03 | +3.381909490E+00 | +4.988824278E+00
-2.485000E-03 | +3.306532606E+00 | +5.064201162E+00
-2.482500E-03 | +3.386934616E+00 | +4.988824278E+00
-2.480000E-03 | +3.467336625E+00 | +5.064201162E+00
-2.477500E-03 | +3.467336625E+00 | +4.988824278E+00
-2.475000E-03 | +3.547738634E+00 | +4.988824278E+00
-2.472500E-03 | +3.547738634E+00 | +5.069226287E+00
-2.470000E-03 | +3.467336625E+00 | +4.988824278E+00
-2.467500E-03 | +3.386934616E+00 | +4.988824278E+00
-2.465000E-03 | +3.381909490E+00 | +4.988824278E+00
-2.462500E-03 | +3.306532606E+00 | +5.069226287E+00
-2.460000E-03 | +3.306532606E+00 | +4.988824278E+00
-2.457500E-03 | +3.467336625E+00 | +4.988824278E+00
-2.455000E-03 | +3.467336625E+00 | +5.069226287E+00
-2.452500E-03 | +3.547738634E+00 | +5.064201162E+00
-2.450000E-03 | +3.547738634E+00 | +5.064201162E+00
-2.447500E-03 | +3.467336625E+00 | +4.988824278E+00
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
