Denhart/uniProject9-10/mockups/007-lasse_double/2016-05-18-opticalboard_vs_no-opticalboard/vna/wonder_no_opticalCh1.csv

# Version 1.00
#
freq[Hz] | Trc1_S21[dB] | Ch1_SG_S11_S11[dB] | Ch1_SG_S12_S12[dB] | Ch1_SG_S21_S21[dB] | Ch1_SG_S22_S22[dB] | RX_S22[dB] | TX_S11[dB] | ISO_S21[dB]
6.000000000000000E+008 | -5.586297046142957E+001 | -4.631724496583424E-001 | -5.590087297552132E+001 | -5.586297046142957E+001 | -2.224821539694414E-001 | -2.224821539694414E-001 | -4.631724496583424E-001 | -5.586297046142957E+001
6.120000000000000E+008 | -5.441524884038574E+001 | -4.812383204410107E-001 | -5.439650859271828E+001 | -5.441524884038574E+001 | -2.421547008516860E-001 | -2.421547008516860E-001 | -4.812383204410107E-001 | -5.441524884038574E+001
6.240000000000000E+008 | -5.334337785605342E+001 | -4.942373174714423E-001 | -5.276908659195556E+001 | -5.334337785605342E+001 | -2.498186989276618E-001 | -2.498186989276618E-001 | -4.942373174714423E-001 | -5.334337785605342E+001
6.360000000000000E+008 | -5.111104418639612E+001 | -5.227012422420659E-001 | -5.128495657683649E+001 | -5.111104418639612E+001 | -2.448182304879851E-001 | -2.448182304879851E-001 | -5.227012422420659E-001 | -5.111104418639612E+001
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
