Denhart/uniProject9-10/hw/meas/2016-04-12-scope_weird_waveform/001-our_noconnect.png

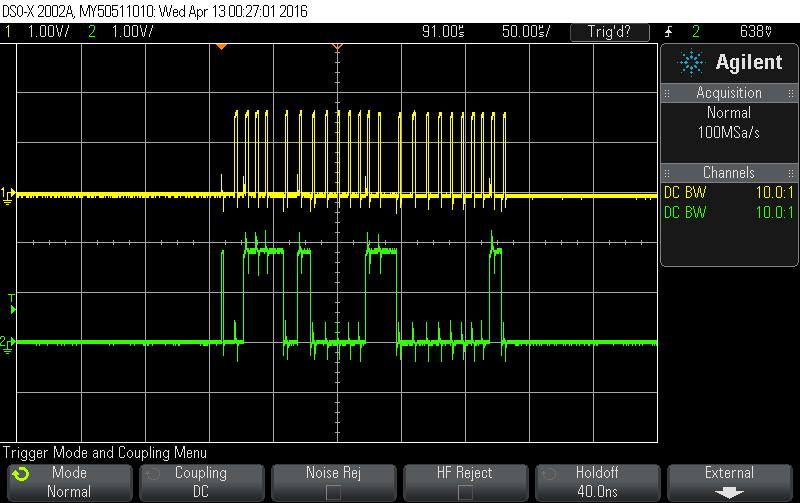
hw/meas/2016-04-12-scope_weird_waveform/001-our_noconnect.png
