Denhart/uniProject9-10/hw/meas/2016-04-12-scope_weird_waveform/002-our_connect.png

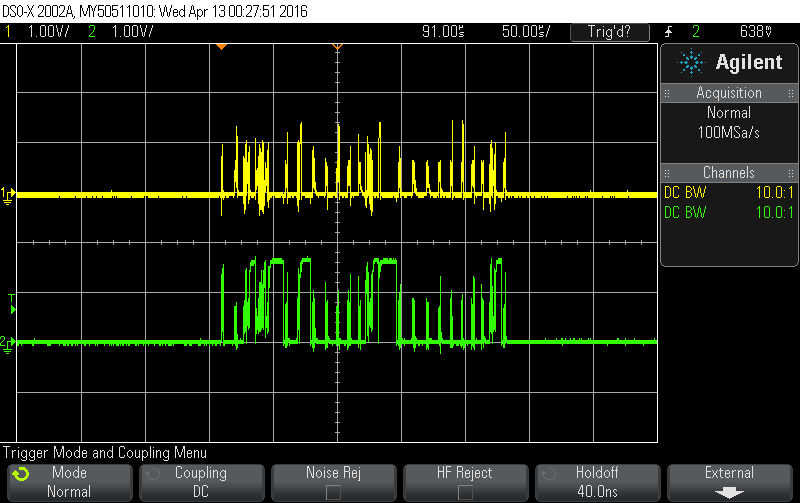
hw/meas/2016-04-12-scope_weird_waveform/002-our_connect.png
