Denhart/uniProject9-10/hw/meas/2016-04-12-scope_weird_waveform/003-wispry_noconnect.png

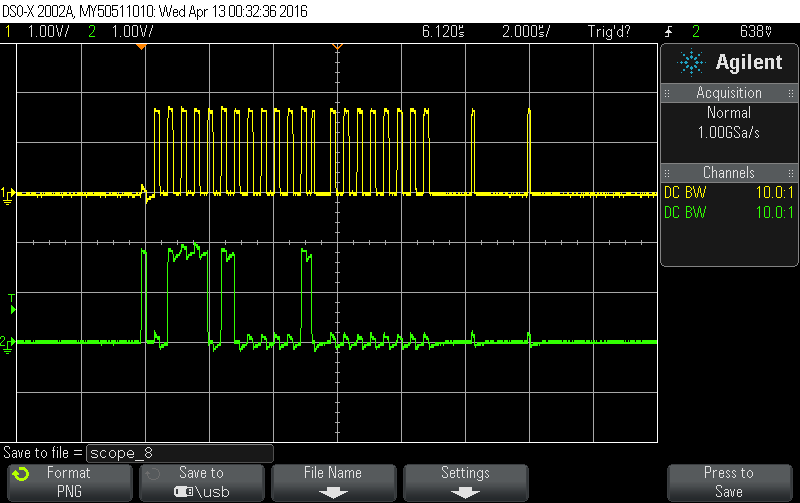
hw/meas/2016-04-12-scope_weird_waveform/003-wispry_noconnect.png
