Denhart/uniProject9-10/hw/meas/soren/avr_rffe_output.png

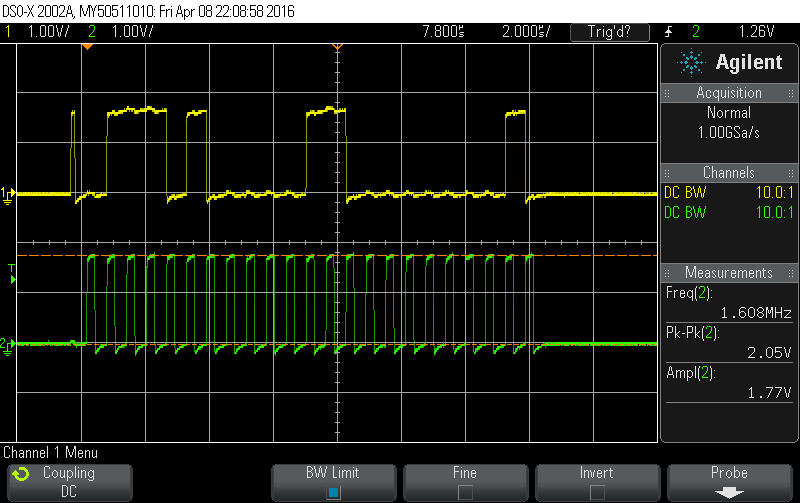
hw/meas/soren/avr_rffe_output.png
