Denhart/uniProject9-10/hw/meas/soren/uart_over_optical.png

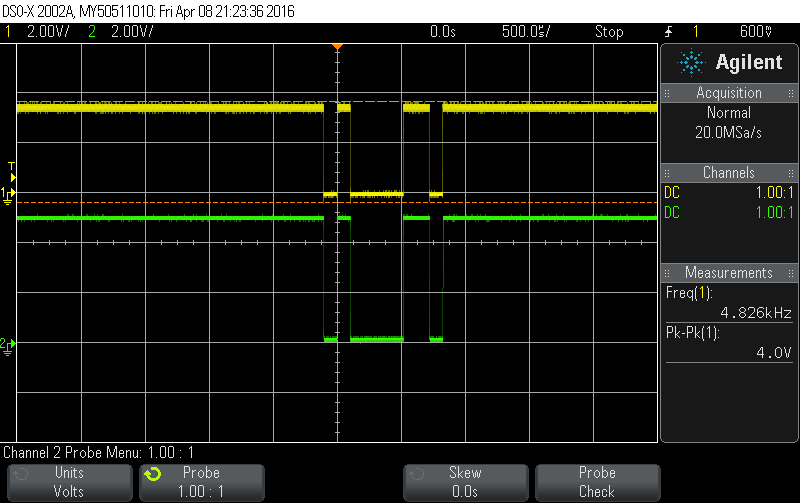
hw/meas/soren/uart_over_optical.png
