Denhart/uniProject9-10/mockups/004-triangle_samboard/triag-side-1.2_1.5_3.0.png

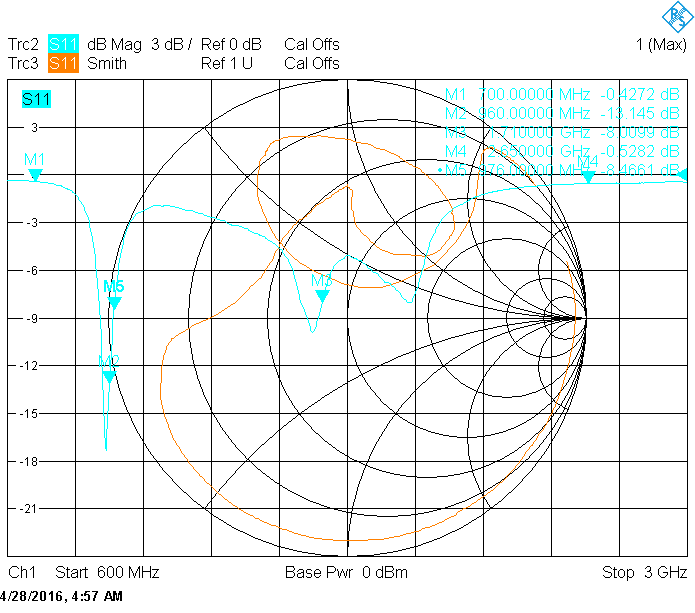
mockups/004-triangle_samboard/triag-side-1.2_1.5_3.0.png
