Denhart/uniProject9-10/mockups/004-triangle_samboard/triag-top_8.2_3.3_0.6.png

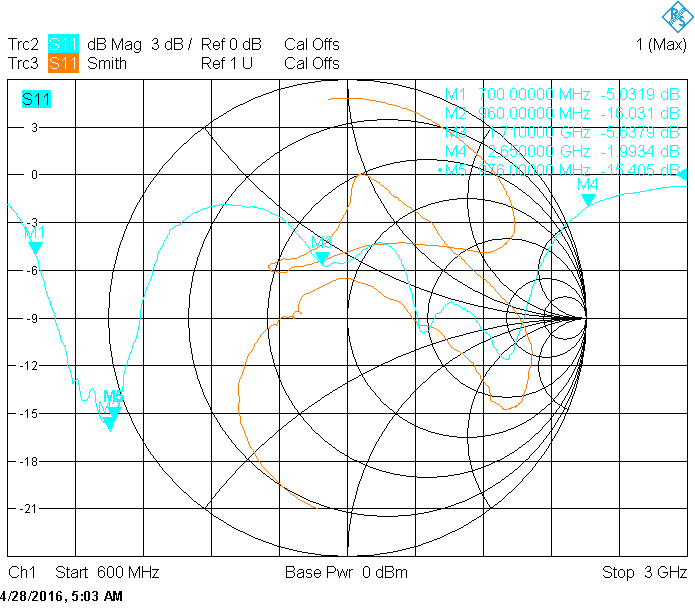
mockups/004-triangle_samboard/triag-top_8.2_3.3_0.6.png
