Denhart/uniProject9-10/mockups/004-triangle_samboard/triag.jpg

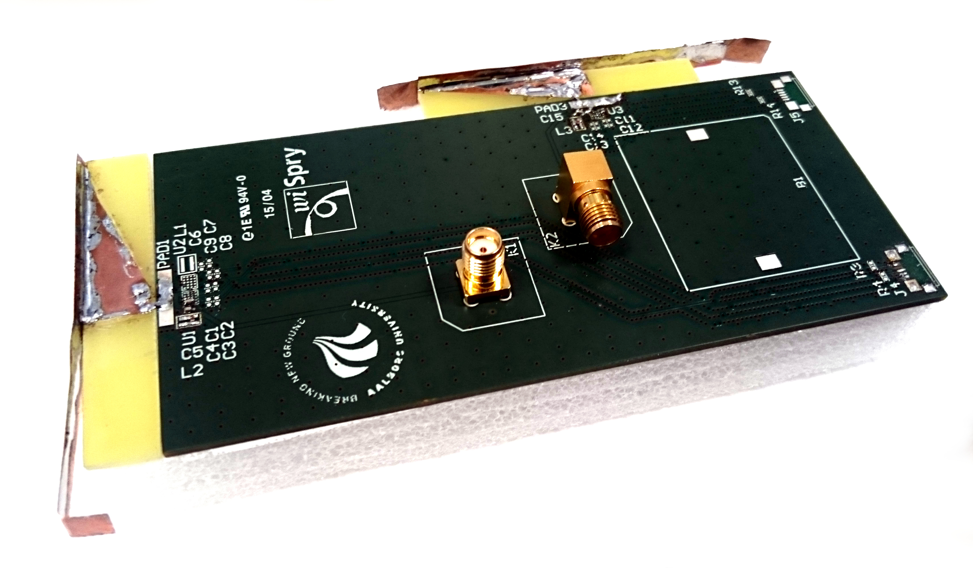
mockups/004-triangle_samboard/triag.jpg
