Denhart/uniProject9-10/mockups/007-lasse_double/2016-05-17-sweeps/img/lassedouble.jpg

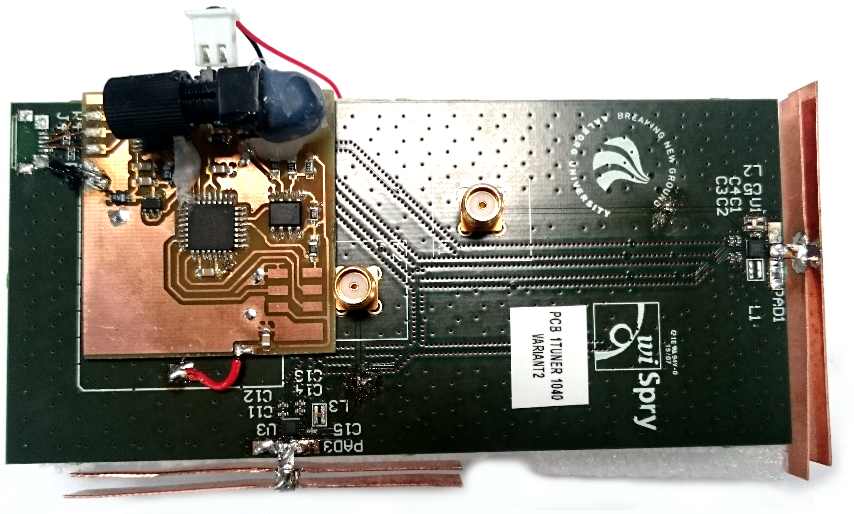
mockups/007-lasse_double/2016-05-17-sweeps/img/lassedouble.jpg
