Denhart/uniProject9-10/rep/img/tech_sol/monopole/highband/ue/sar/3d_sar.PNG

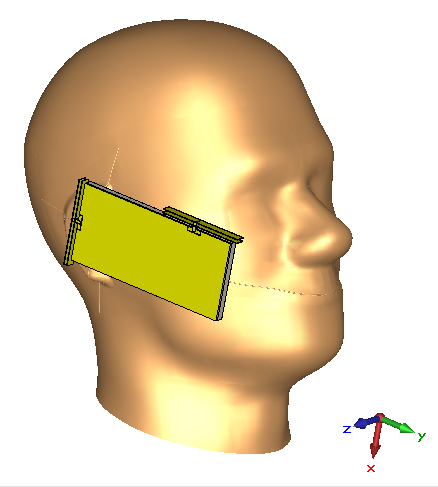
rep/img/tech_sol/monopole/highband/ue/sar/3d_sar.PNG
