Denhart/uniProject9-10/rep/img/tech_sol/pcb_trianglefeed/pcb.jpg

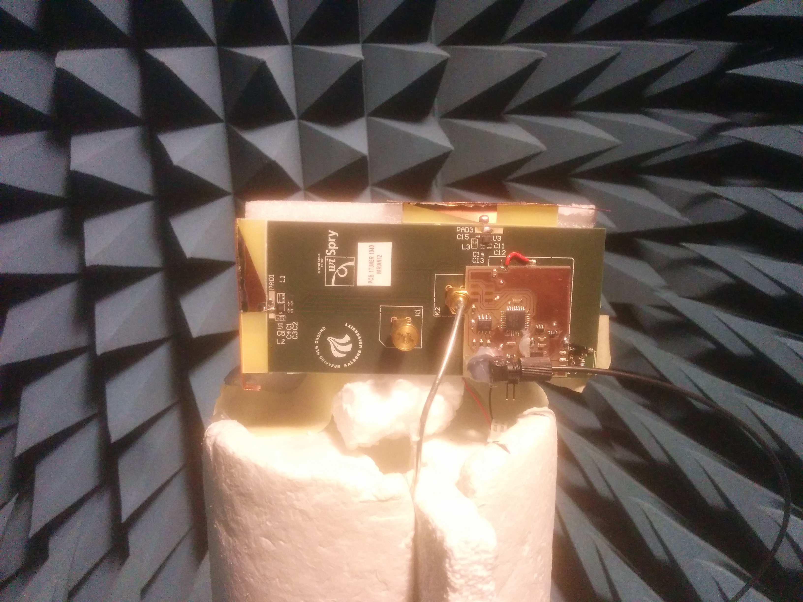
rep/img/tech_sol/pcb_trianglefeed/pcb.jpg
