Denhart/uniProject9-10/rep/img/tech_sol/trianglefeed/data_mode/3d.PNG

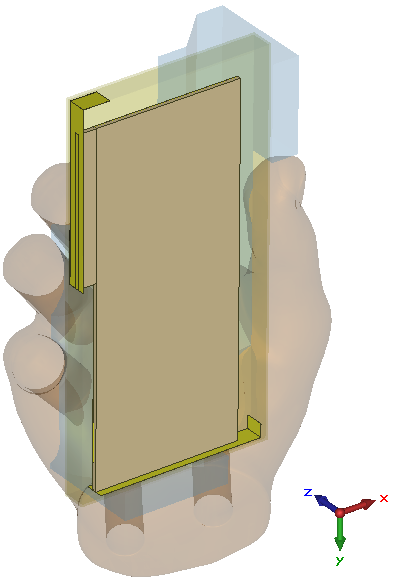
rep/img/tech_sol/trianglefeed/data_mode/3d.PNG
