Denhart/uniProject9-10/rep/img/tech_sol/trianglefeed/sar/3d.PNG

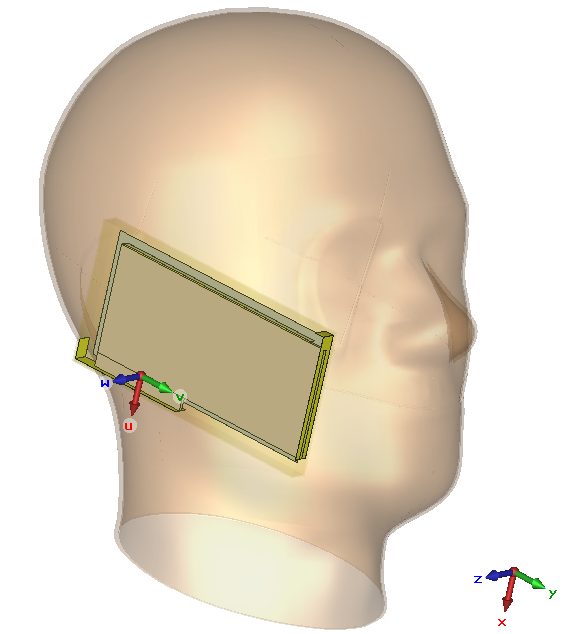
rep/img/tech_sol/trianglefeed/sar/3d.PNG
