Denhart/uniProject9-10/sim/lt/sim_data/mono_5mm_highband/3d_side.png

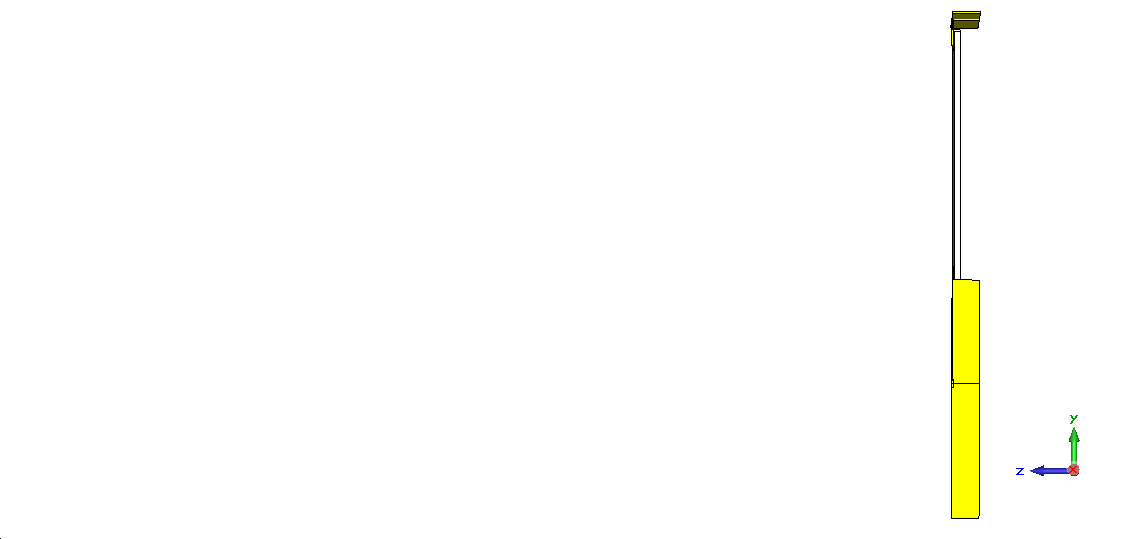
sim/lt/sim_data/mono_5mm_highband/3d_side.png
