Denhart/uniProject9-10/sim/lt/sim_data/mono_5mm_highband/Udklip.PNG

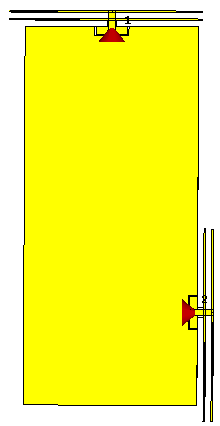
sim/lt/sim_data/mono_5mm_highband/Udklip.PNG
