Denhart/uniProject9-10/sim/lt/sim_data/mono_V12/3d_drawing/3D.png

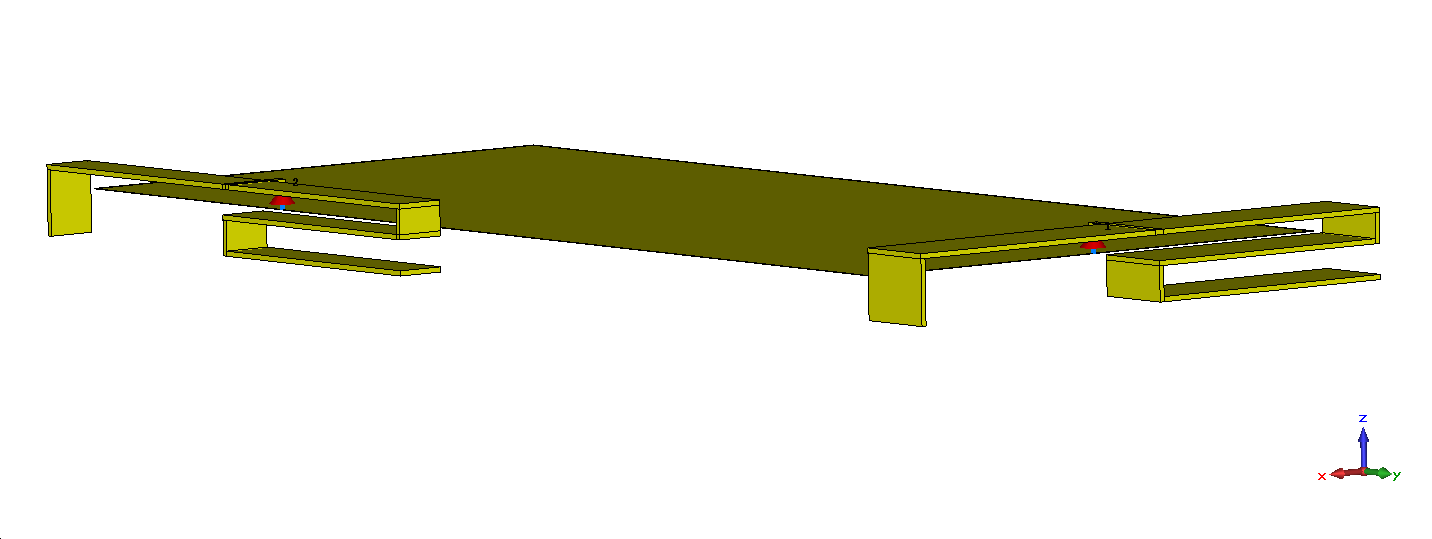
sim/lt/sim_data/mono_V12/3d_drawing/3D.png
