Denhart/uniProject9-10/sim/sn/011-wideband_lowband/results/schematic.PNG

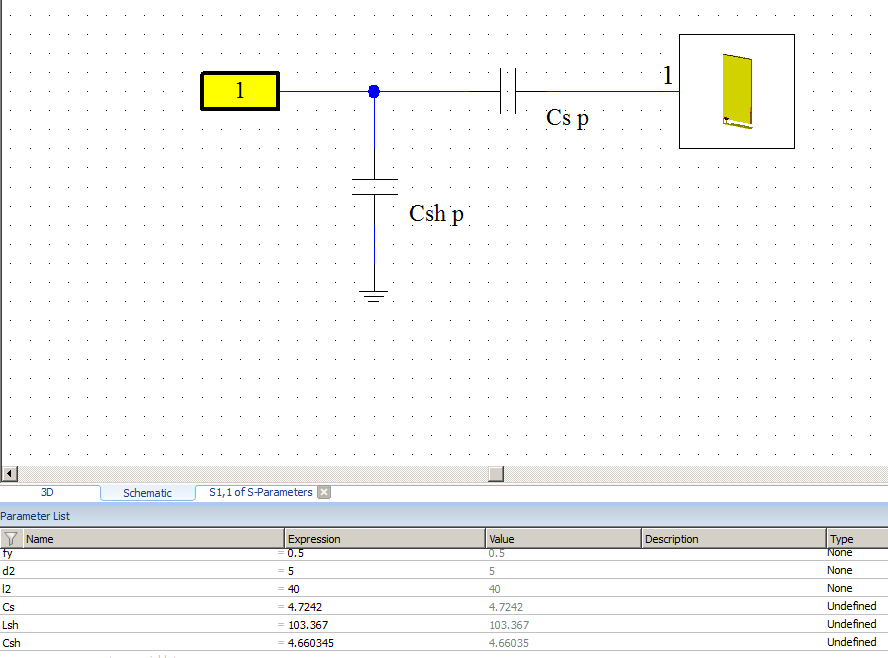
sim/sn/011-wideband_lowband/results/schematic.PNG
