Denhart/uniProject9-10/sim/sn/014-ilvonen2014design/2015-12-15-user_effects/sar/3d.PNG

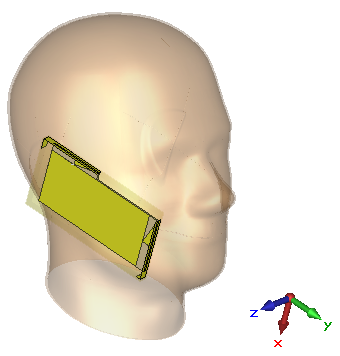
sim/sn/014-ilvonen2014design/2015-12-15-user_effects/sar/3d.PNG
