Denhart/uniProject9-10/sim/sn/014-ilvonen2014design/results/schematic.bmp

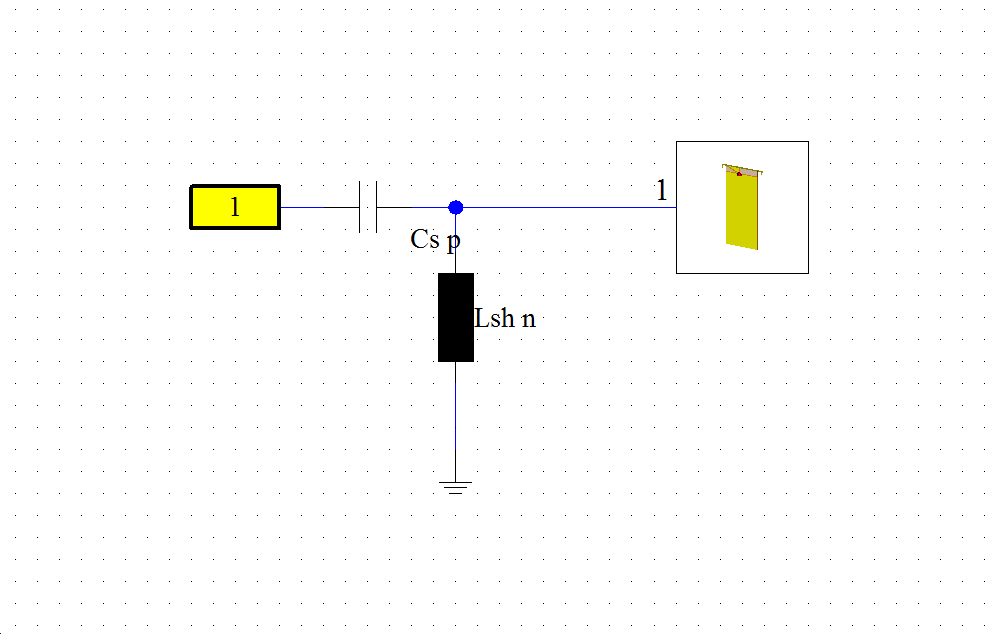
sim/sn/014-ilvonen2014design/results/schematic.bmp
