Denhart/uniProject9-10/rep/img/tech_sol/samanthas_board.dxf

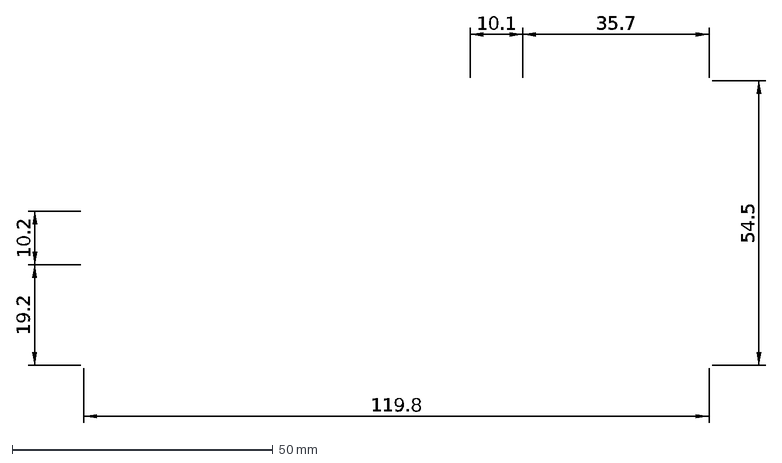
[picture p47: CAD file, 2016-03-14]
rep/img/tech_sol/samanthas_board.dxf
119.8
19.2
10.2
54.5
35.7
10.1
