Denhart/uniProject9-10/sim/sn/014-ilvonen2014design/technical_drawing.dxf

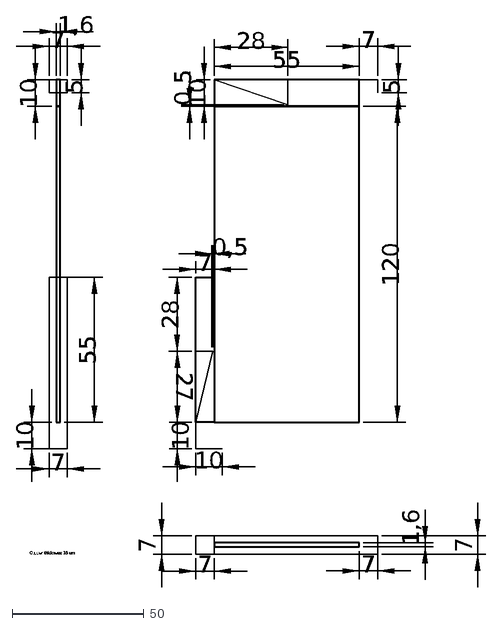
[picture p48: CAD file, 2016-03-11]
sim/sn/014-ilvonen2014design/technical_drawing.dxf
120
5
55
7
28
10
0,5
27
1,6
Copper thickness: 35 um
