Denhart/uniProject9-10/(list of files, cad)

Other CAD files:
sim/lt/ifa-v1/ModelCache/Model.psm
