Denhart/uniProject9-10/mockups/001-trianglefeed/measurements/03_satimo/matlab/SatimoPassiveGuide.docx

Start SPM 1.2

Start a measurement

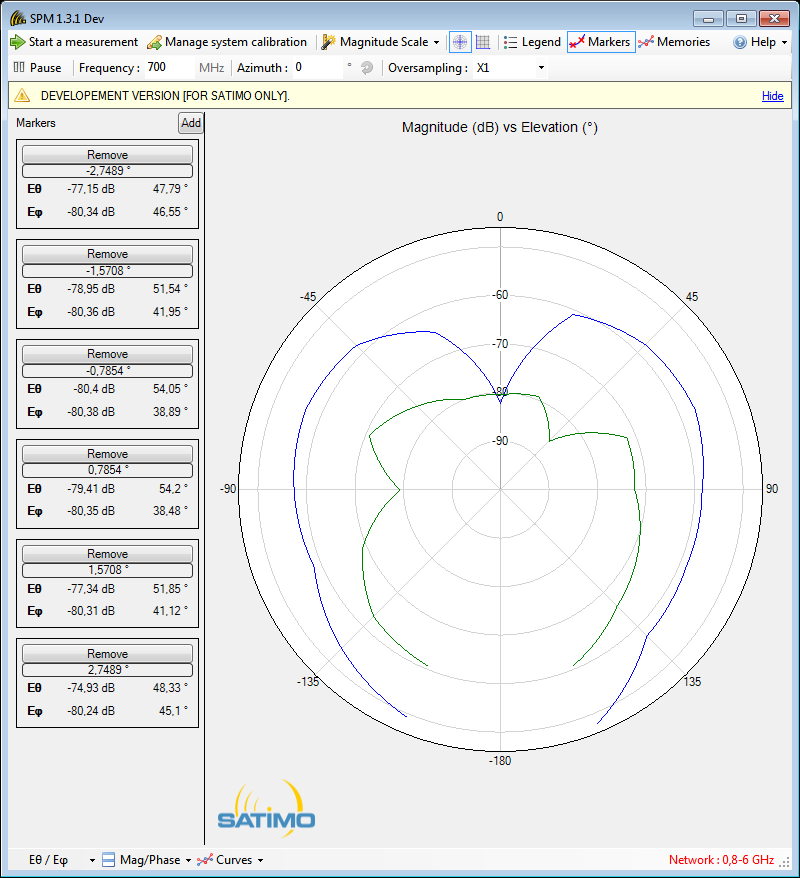
[picture p49: figure]

1

Choose the following settings (Matlab hard coded for range [700-1000] MHz and 2.5 MHz resolution)

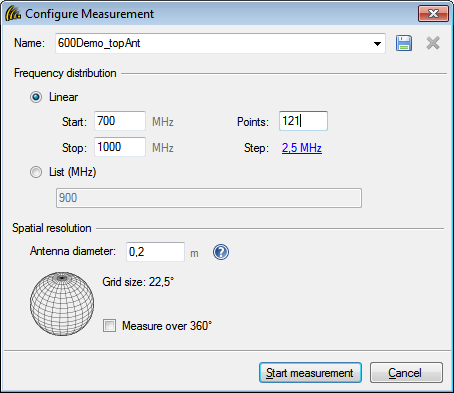
[picture p50: figure]

Export the raw data

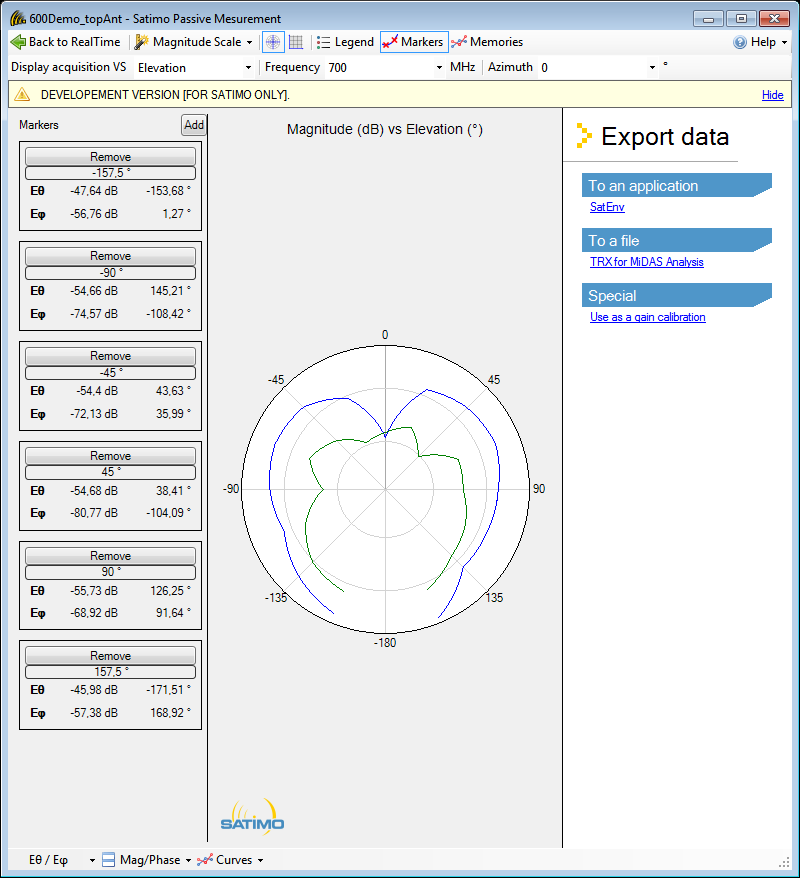
[picture p51: figure]
