Denhart/uniProject9-10/sim/sn/018-transmission_line/results/setup.png

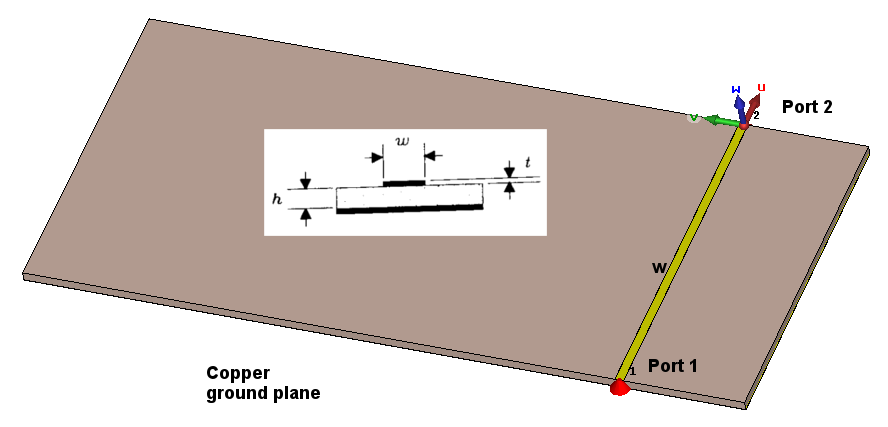
sim/sn/018-transmission_line/results/setup.png
