Denhart/uniProject9-10/mockups/001-trianglefeed/measurements/2016-02-26-sparameters_and_efficiency/README.md

# Component values:

    |---------+--------+--------+--------|
    | Antenna | C      | L      | Csh    |
    |---------+--------+--------+--------|
    | Top     | 2.2 pF | 6.8 nH | 0.9 pF |
    | Side    | 2.2 pF | 5.6 nH | 0.3 pF |
    |---------+--------+--------+--------|
