Denhart/uniProject9-10/mockups/002-monopole/measurements/2016-03-30-sweeping_capacitors/README.txt

# Initial component values

|------+--------+--------+--------|
|      | Cs     | Lsh    | Csh    |
|------+--------+--------+--------|
| Top  | 2.2 pF | 3.3 nH | 0.3 pF |
| Side | 3.3 pF | 1.2 nH | 0.3 pF |
|------+--------+--------+--------|

# Position
Vertical
