Denhart/uniProject9-10/mockups/001-trianglefeed/measurements/2016-03-08-triangle_both_efficiency/efficiency.pdf

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

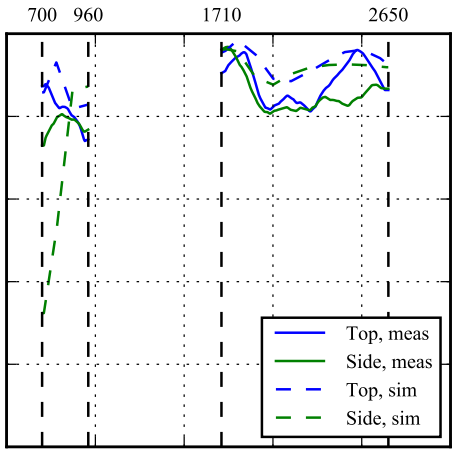
[picture p53: figure]
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
