Denhart/uniProject9-10/sim/sn/018-transmission_line/results/w2_9.pdf

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

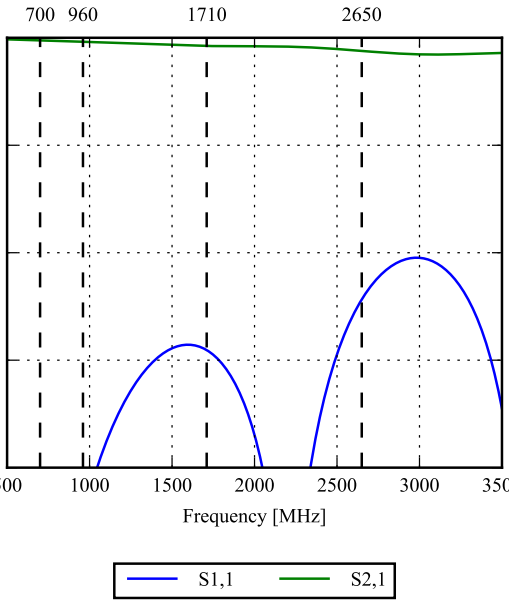
[picture p54: figure]
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
