Denhart/uniProject9-10/mockups/001-trianglefeed/measurements/03_sparams.csv

# Version 1.00
#
freq[Hz] | re:Trc2_S12 | im:Trc2_S12 | re:Trc3_S21 | im:Trc3_S21 | re:Trc4_S22 | im:Trc4_S22 | re:Trc5_S11 | im:Trc5_S11
4.000000000000000E+008 | -9.027529740706086E-004 | -1.444715075194836E-003 | -8.850907906889916E-004 | -1.518877455964685E-003 | -9.181943535804749E-001 | 2.974288463592529E-001 | -6.983520984649658E-001 | 6.664424538612366E-001
4.004333333333333E+008 | -9.333600173704326E-004 | -1.439025858417153E-003 | -9.539201855659485E-004 | -1.510756206698716E-003 | -9.174249172210693E-001 | 3.006511032581329E-001 | -6.951330900192261E-001 | 6.696324944496155E-001
4.008666666666667E+008 | -9.344987920485437E-004 | -1.569200539961457E-003 | -9.254042524844408E-004 | -1.513954135589302E-003 | -9.167017340660095E-001 | 3.041707575321198E-001 | -6.918991804122925E-001 | 6.728139519691467E-001
4.013000000000000E+008 | -9.526094654574990E-004 | -1.544383587315679E-003 | -9.643567609600723E-004 | -1.529757864773274E-003 | -9.159126877784729E-001 | 3.074899017810822E-001 | -6.884796023368835E-001 | 6.757743358612061E-001
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
