Denhart/uniProject9-10/mockups/001-trianglefeed/measurements/2016-02-25-sparameters_good_vna/Csh1_09_Csh2_11.csv

# Version 1.00
#
freq[Hz] | db:Trc1_S11 | ang:Trc1_S11 | db:Trc2_S21 | ang:Trc2_S21 | db:Trc3_S22 | ang:Trc3_S22
5.000000000000000E+008 | -4.797164602736651E-001 | 9.065786698194762E+001 | -4.373356539939632E+001 | -1.685801271760122E+002 | -4.085733141385976E-001 | 1.091356681608837E+002
5.125000000000000E+008 | -5.073458144234444E-001 | 8.235613717968266E+001 | -4.126367421844002E+001 | -1.747800960671409E+002 | -4.254818787484109E-001 | 1.021571630291633E+002
5.250000000000000E+008 | -5.748975539162977E-001 | 7.370134795370849E+001 | -3.854066784818789E+001 | 1.752159188028674E+002 | -4.454063241326519E-001 | 9.493198565390648E+001
5.375000000000000E+008 | -6.347673965473493E-001 | 6.487236699419056E+001 | -3.600996418873481E+001 | 1.663816779277795E+002 | -4.845084409247118E-001 | 8.763078824223665E+001
5.500000000000000E+008 | -7.365822171317171E-001 | 5.566109465341006E+001 | -3.305130938185496E+001 | 1.554542904050564E+002 | -5.112680120762240E-001 | 8.025249207222107E+001
5.625000000000000E+008 | -8.594550574634418E-001 | 4.601647996116891E+001 | -3.004464473334198E+001 | 1.411470341708346E+002 | -5.682847131303540E-001 | 7.243746199352233E+001
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
