Denhart/uniProject9-10/mockups/002-monopole/measurements/2016-03-29-both_03_pf/sparams/lasse_03_03.csv

# Version 1.00
#
freq[Hz] | Trc1_S11[dB] | Trc2_S11[dB] | Trc3_S22[dB] | Trc4_S21[dB]
5.000000000000000E+008 | -3.578656441842226E-001 | -3.578656441842226E-001 | -4.473391125802987E-001 | -5.280497471921680E+001
5.031250000000000E+008 | -3.551478485006540E-001 | -3.551478485006540E-001 | -4.374618424443006E-001 | -5.250374878378933E+001
5.062500000000000E+008 | -3.635348776647527E-001 | -3.635348776647527E-001 | -4.503932661971062E-001 | -5.208596821296131E+001
5.093750000000000E+008 | -3.639339821351458E-001 | -3.639339821351458E-001 | -4.386421784911140E-001 | -5.156824812508800E+001
5.125000000000000E+008 | -3.586065775824486E-001 | -3.586065775824486E-001 | -4.494415991724293E-001 | -5.124321596557049E+001
5.156250000000000E+008 | -3.579217137447719E-001 | -3.579217137447719E-001 | -4.506042773215976E-001 | -5.070977665243461E+001
5.187500000000000E+008 | -3.521664793585240E-001 | -3.521664793585240E-001 | -4.500764853107955E-001 | -5.027271273652971E+001
5.218750000000000E+008 | -3.459273564433956E-001 | -3.459273564433956E-001 | -4.593486738042985E-001 | -4.956637412590517E+001
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
