Denhart/uniProject9-10/mockups/001-trianglefeed/measurements/2016-02-23-matching_top_antenna/sparams/trace/b.csv

x | Curve1
500.67 | -0.163
526.2 | -0.234
555.99 | -0.421
581.89 | -0.93
609.46 | -1.904
622.31 | -2.942
636.14 | -3.983
655.87 | -5.064
675.99 | -6.875
691.13 | -7.896
707.88 | -8.564
724.31 | -9.302
730.89 | -9.7
749.53 | -9.595
773.08 | -9.463
803.06 | -8.076
821.96 | -7.222
851.38 | -6.772
875.52 | -5.949
892.47 | -5.232
910.11 | -4.83
932.04 | -4.888
961.51 | -5.163
998.84 | -5.445
1011.94 | -5.544
1022.76 | -5.87
1042.42 | -6.186
1055.52 | -6.224
1089.18 | -5.75
1104.84 | -5.187
1116.26 | -4.78
1125.4 | -4.6
1131.92 | -4.307
1139.44 | -4.211
1151.22 | -4.274
1165.93 | -4.079
1177.05 | -3.96
1202.24 | -3.947
1221.2 | -3.711
1242.14 | -3.618
1252.27 | -3.549
1264.7 | -3.426
1290.2 | -3.217
1308.51 | -3.071
1328.13 | -2.877
1349.39 | -2.735
1362.15 | -2.71
1384.4 | -2.745
1404.69 | -2.773
1422.05 | -2.912
1438.77 | -3.311
1455.16 | -3.651
1467.62 | -3.956
1473.52 | -4.092
1492.82 | -3.994
1510.16 | -3.988
1527.86 | -4.309
1544.26 | -4.678
1559.33 | -4.901
1575.05 | -5.082
1588.48 | -5.283
1597.02 | -5.594
1613.75 | -6.045
1625.56 | -6.464
1634.77 | -6.919
1644.97 | -7.577
1664 | -8.181
1675.82 | -8.654
1684.38 | -9.251
1698.17 | -9.744
1715.88 | -10.26
1729.02 | -10.797
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
