Denhart/uniProject9-10/mockups/001-trianglefeed/measurements/2016-02-23-matching_top_antenna/sparams/L1_56.jpg

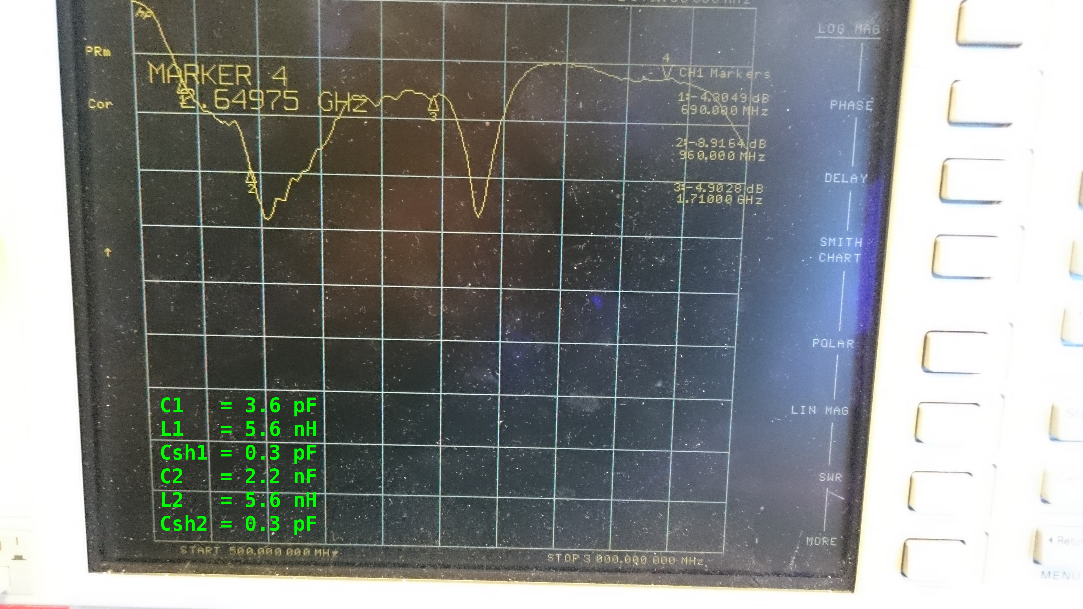
mockups/001-trianglefeed/measurements/2016-02-23-matching_top_antenna/sparams/L1_56.jpg
