Denhart/uniProject9-10/mockups/001-trianglefeed/measurements/2016-02-23-matching_top_antenna/sparams/trace/b.JPG

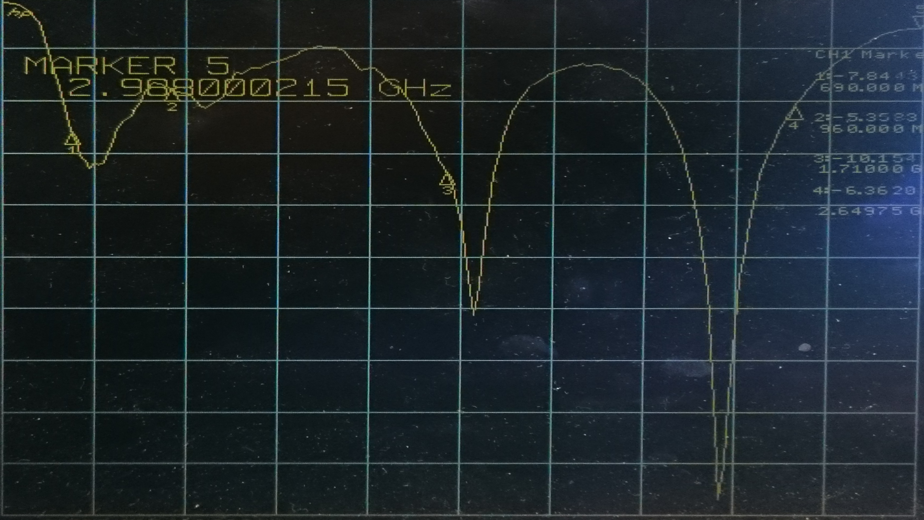
mockups/001-trianglefeed/measurements/2016-02-23-matching_top_antenna/sparams/trace/b.JPG
