Denhart/uniProject9-10/mockups/001-trianglefeed/measurements/2016-02-24-matching_side_antenna/sparams/initial.JPG

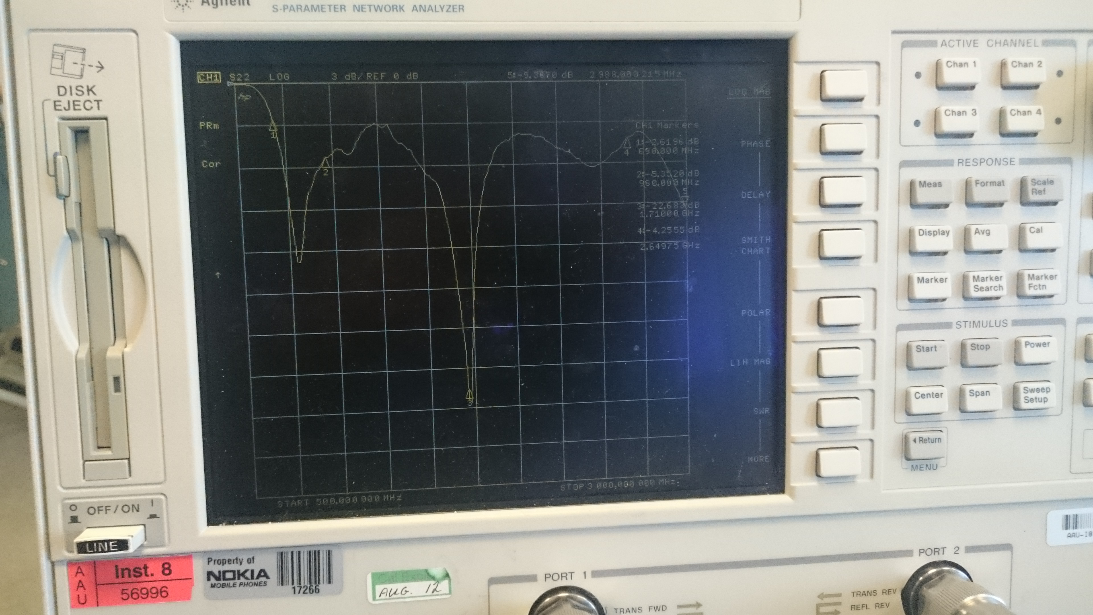
mockups/001-trianglefeed/measurements/2016-02-24-matching_side_antenna/sparams/initial.JPG
