Denhart/uniProject9-10/mockups/001-trianglefeed/measurements/2016-02-26-sparameters_and_efficiency/satimo/.png

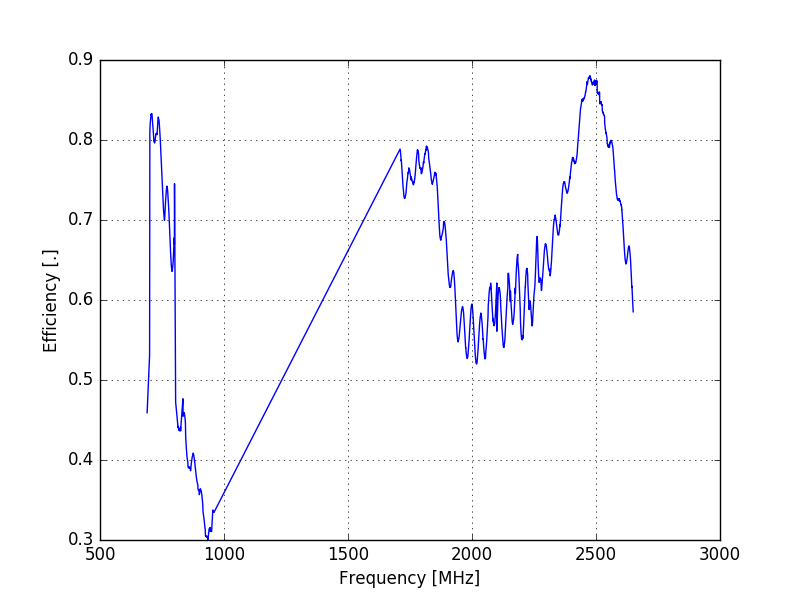
mockups/001-trianglefeed/measurements/2016-02-26-sparameters_and_efficiency/satimo/.png
