Denhart/uniProject9-10/scripts/test/Test_Satimo/FF3d2450.png

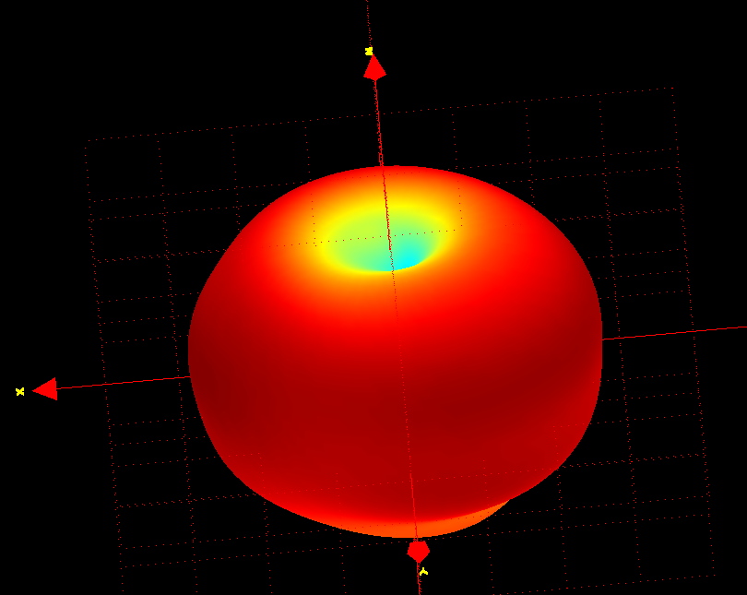
scripts/test/Test_Satimo/FF3d2450.png
