Denhart/uniProject9-10/scripts/test/Test_Satimo/patch/3d_2450_satenv.PNG

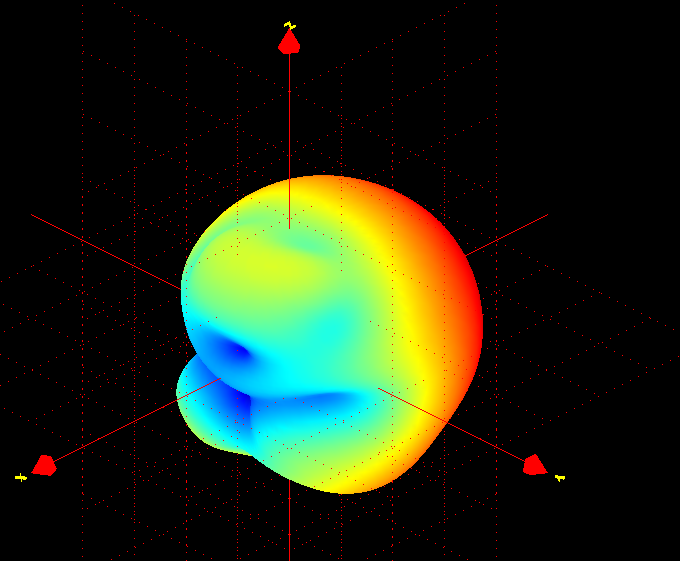
scripts/test/Test_Satimo/patch/3d_2450_satenv.PNG
