Denhart/uniProject9-10/sim/sn/011-wideband_lowband/results/3d.PNG

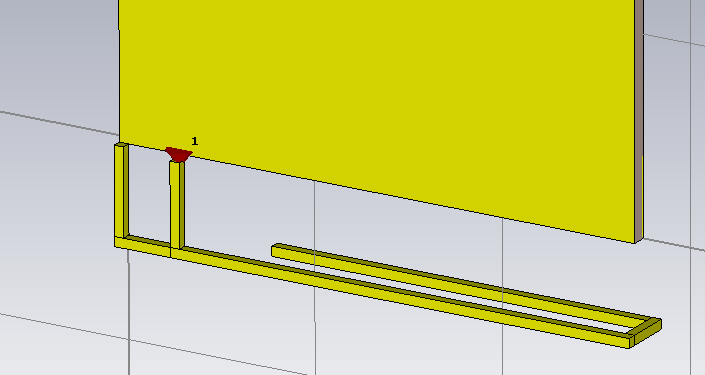
sim/sn/011-wideband_lowband/results/3d.PNG
