Denhart/uniProject9-10/sim/sn/011-wideband_lowband/results/s11.bmp

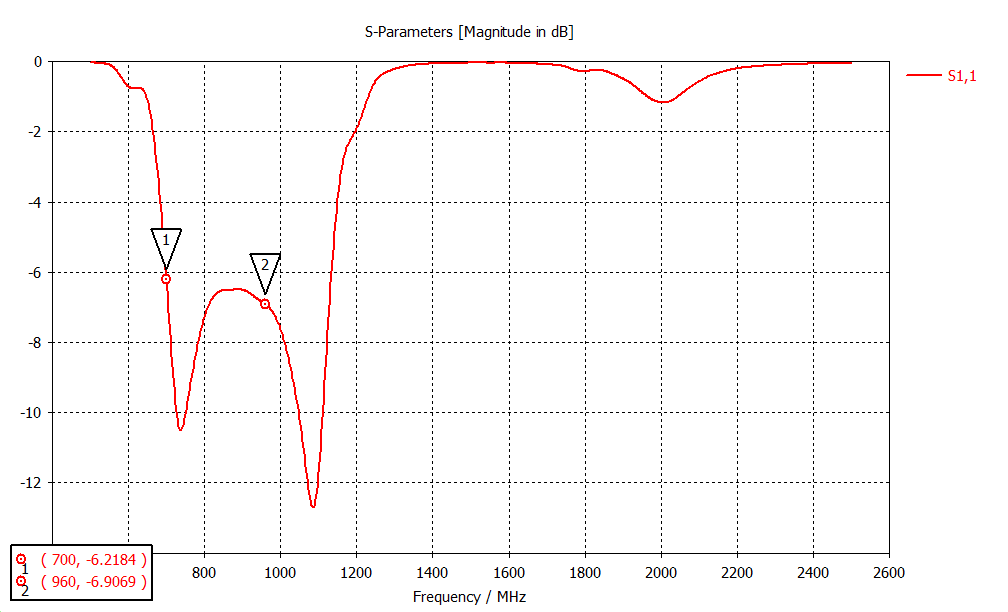
sim/sn/011-wideband_lowband/results/s11.bmp
