Denhart/uniProject9-10/sim/sn/014-ilvonen2014design/2015-12-15-user_effects/sar/lte_sar_results.png

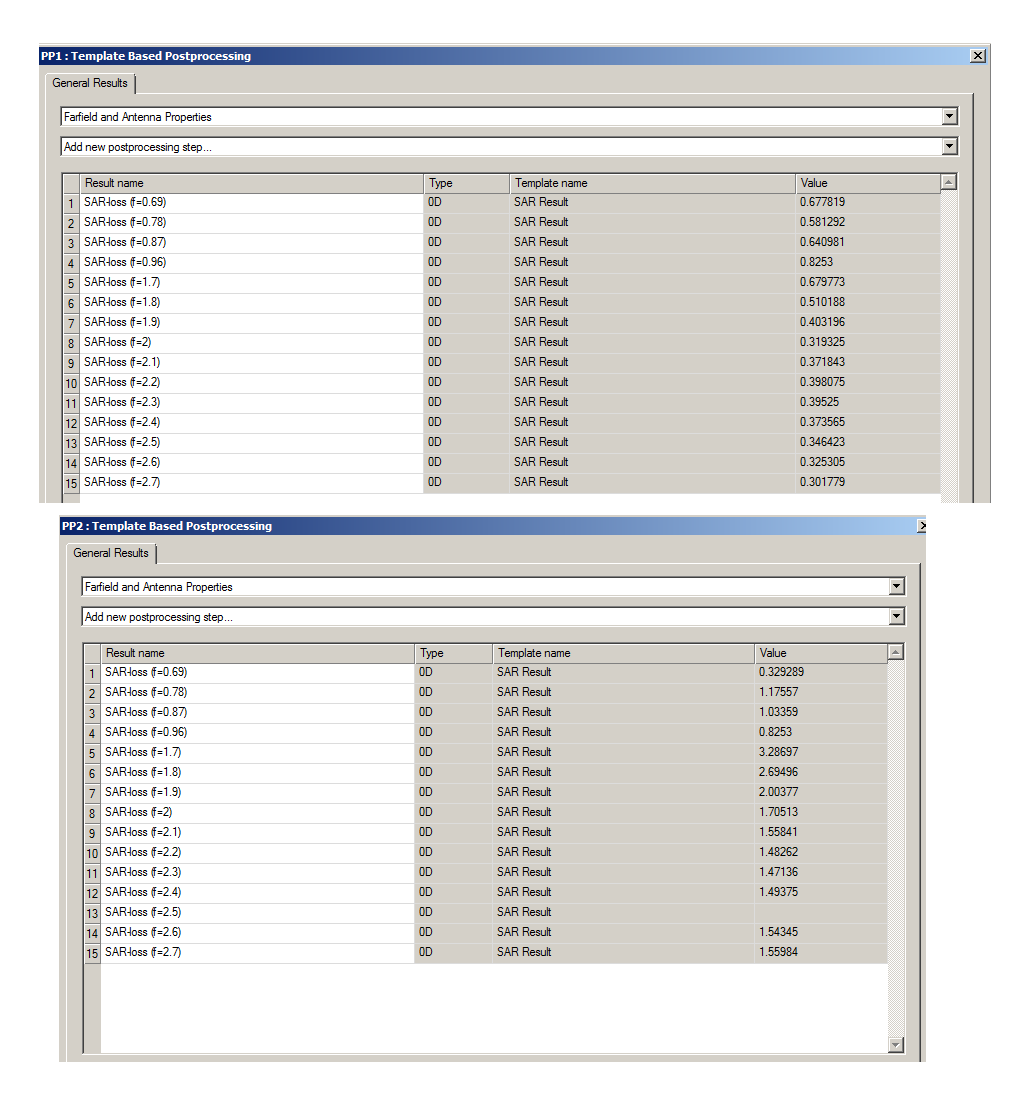
sim/sn/014-ilvonen2014design/2015-12-15-user_effects/sar/lte_sar_results.png
