Denhart/uniProject9-10/sim/sn/014-ilvonen2014design/results/antenna.png

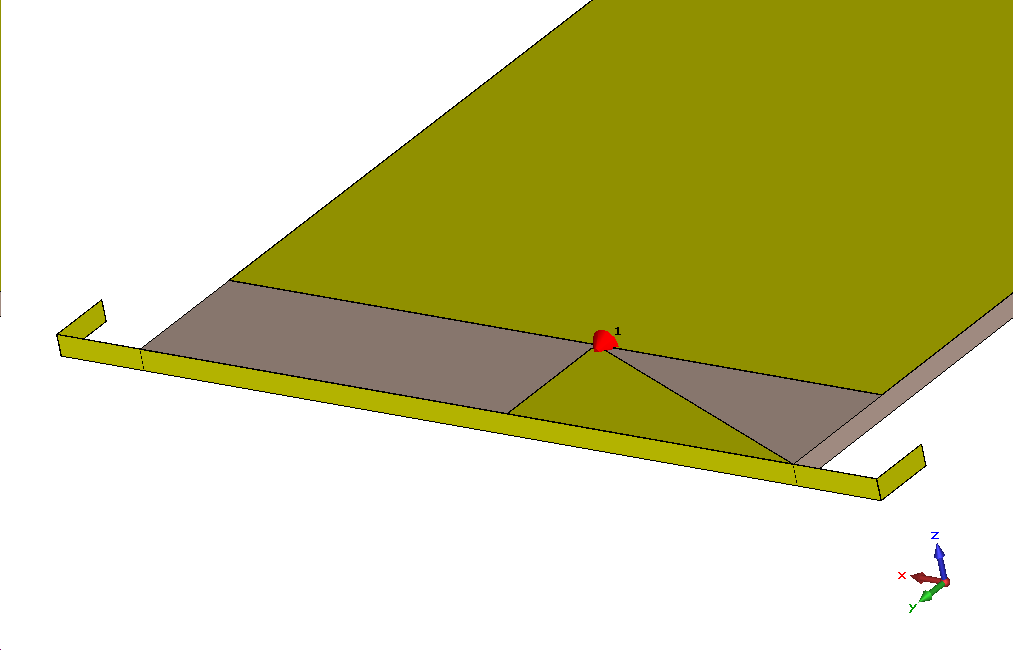
sim/sn/014-ilvonen2014design/results/antenna.png
