Denhart/uniProject9-10/sim/sn/014-ilvonen2014design/results/parameters.PNG

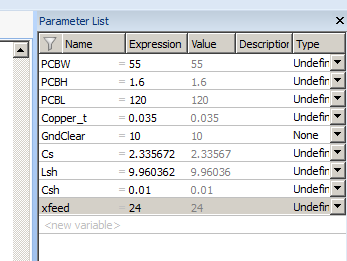
sim/sn/014-ilvonen2014design/results/parameters.PNG
