Denhart/uniProject9-10/sim/sn/014-ilvonen2014design/results/s11_unmatched.bmp

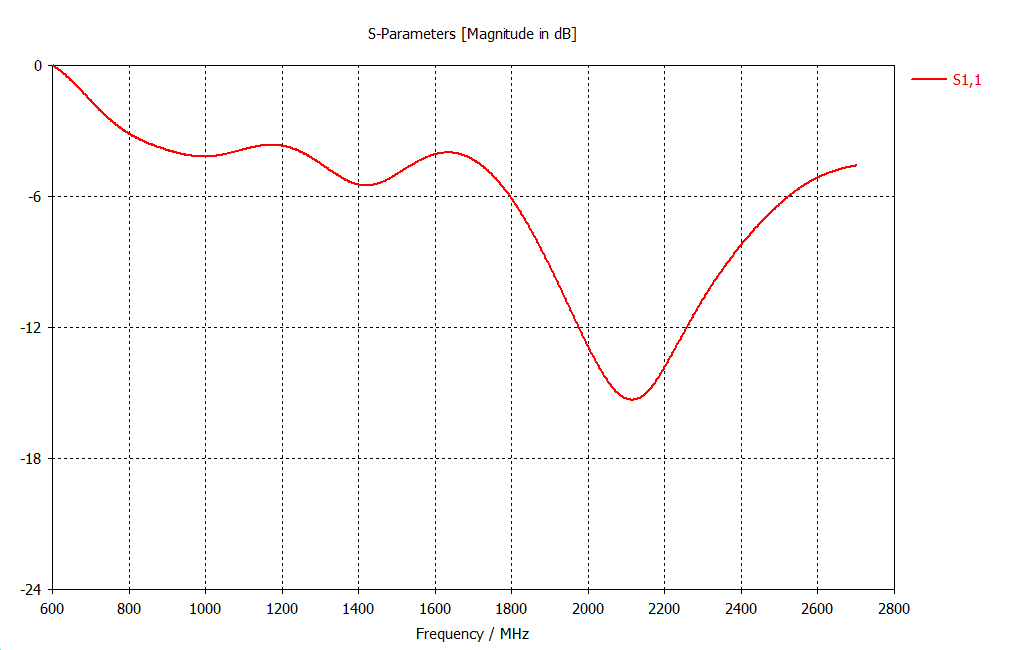
sim/sn/014-ilvonen2014design/results/s11_unmatched.bmp
