Denhart/uniProject9-10/mockups/001-trianglefeed/measurements/2016-02-26-sparameters_and_efficiency/satimo/debug_py.txt

-1.959346236180315115e+00
-1.895341632618143590e+00
-1.843896870452135683e+00
-1.805834201383098359e+00
-1.783772461470663373e+00
-1.782515563603612740e+00
-1.794462214492247076e+00
-1.825475661056690013e+00
-1.881401031473863839e+00
-1.947375225547905986e+00
-2.029664812844144350e+00
-2.126370540120628316e+00
-2.234623442699960716e+00
-2.347011677276849007e+00
-2.460731745601530296e+00
-2.564372332461708037e+00
-2.661962138057988092e+00
-2.741931639063535098e+00
-2.802081698432850043e+00
-2.834817682663597349e+00
-2.842395828470109631e+00
-2.831381376498712577e+00
-2.789404048362819744e+00
-2.724879053635444581e+00
-2.640039965517102072e+00
-2.542088673234604634e+00
-2.431477237766977773e+00
-2.323949848366550608e+00
-2.208697849785305145e+00
-2.105017256383925339e+00
-2.005768247124949610e+00
-1.925027472217685887e+00
-1.863332508011714683e+00
-1.812491033604682666e+00
-1.794346069506788321e+00
-1.783264993906455098e+00
-1.801715486569270608e+00
-1.833463966904557152e+00
-1.889367072885047349e+00
-1.957059665127800718e+00
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
