Denhart/uniProject9-10/pres/img/henrik/schematic_tuning.pdf

# }Top Antenna }Side Antenna

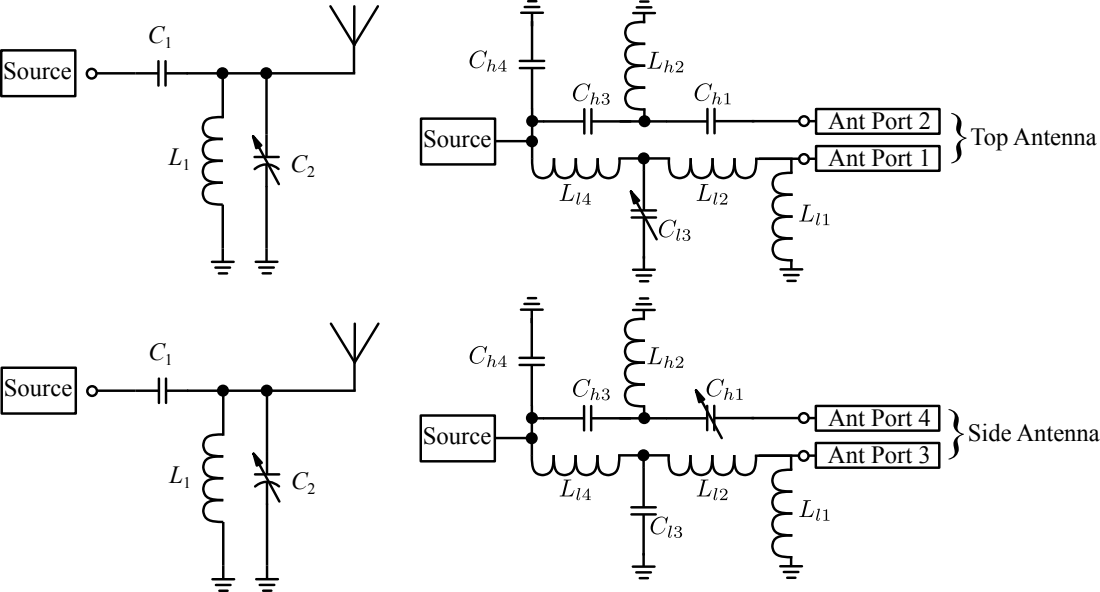
[picture p87: page 1]
Source; Ant Port 4 Ant Port 3; Ant Port 2 Ant Port 1
