Denhart/uniProject9-10/rep/img/optical_rffe/schematic_pc.pdf

3 V⁻ 4 V⁺

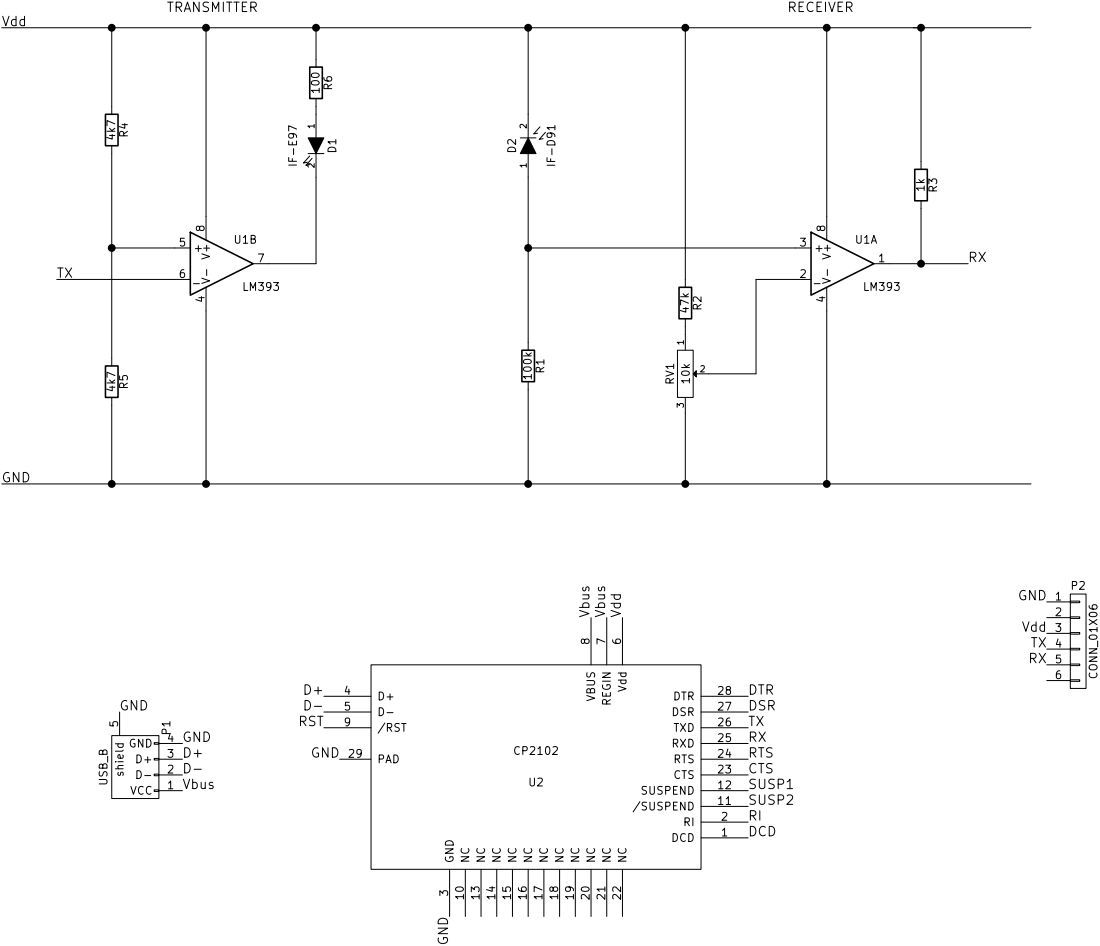
[picture p88: page 1]

1 2 D2 IF-D91 DCD 1 RI 2 GND
