Denhart/uniProject9-10/rep/img/tech_sol/nonresonant/schematic_tuning.pdf

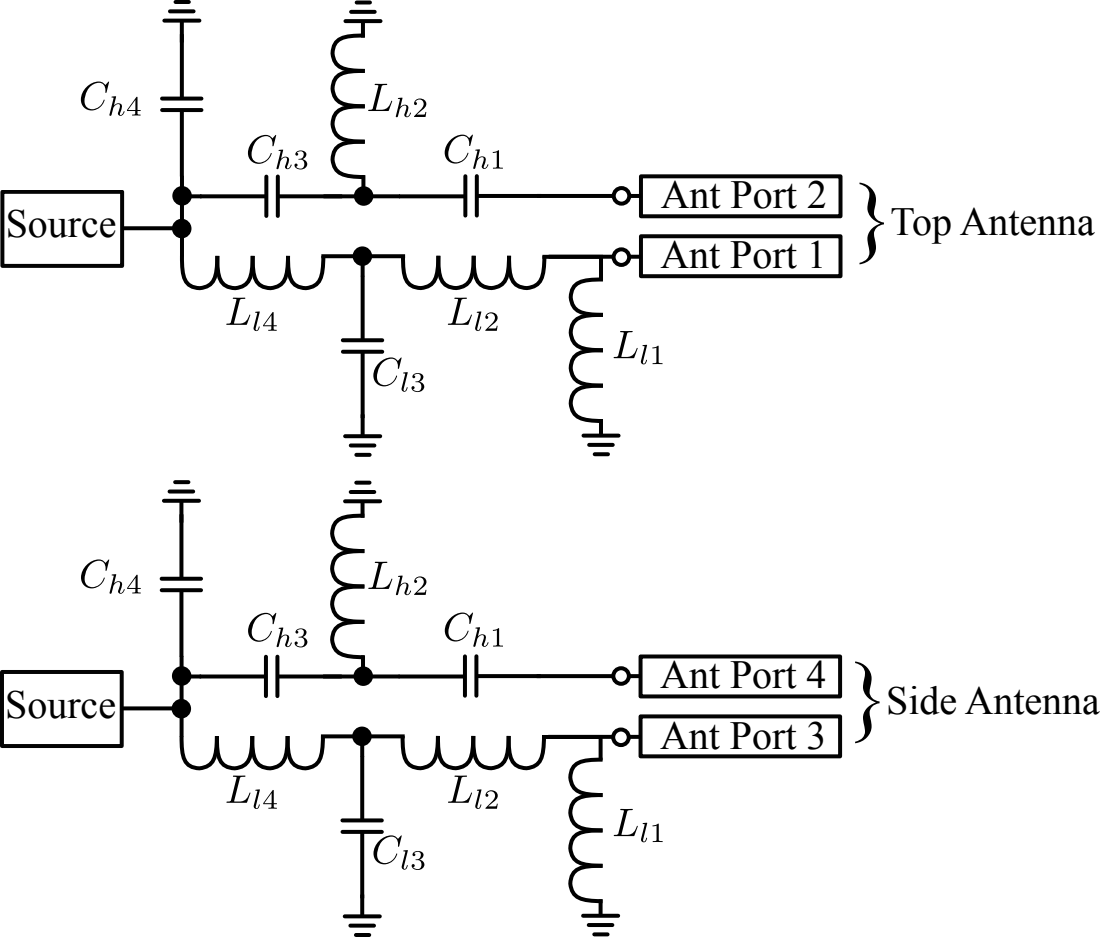
[picture p89: page 1]
Source; Ant Port 4 Ant Port 3; }Side Antenna

Ant Port 1 }Top Antenna
Ant Port 2
