Denhart/uniProject9-10/mockups/007-lasse_double/2016-05-11-opticalboard_vs_no-opticalboard/sparams2.pdf

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

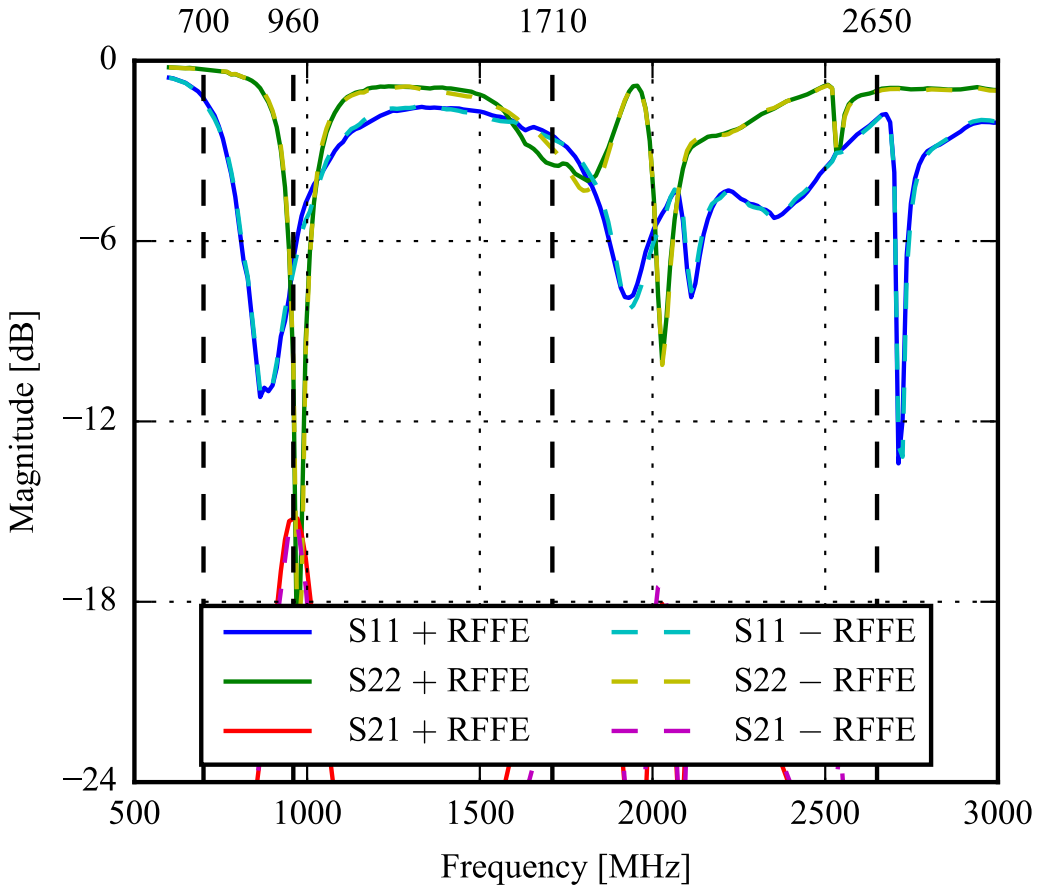
[picture p90: page 1]
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
