Denhart/uniProject9-10/rep/img/optical_rffe/compare_efficiency.pdf

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

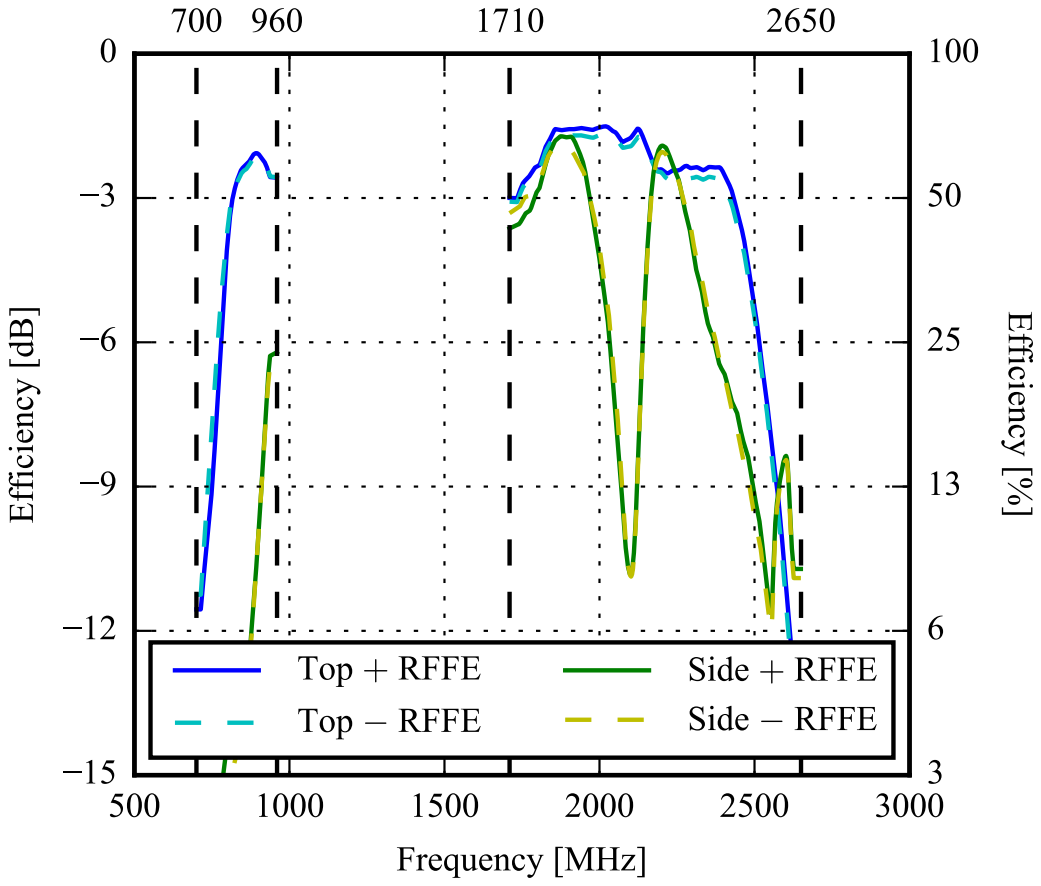
[picture p91: page 1]
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
