Denhart/uniProject9-10/rep/img/optical_rffe/schematic_ant.pdf

1
_

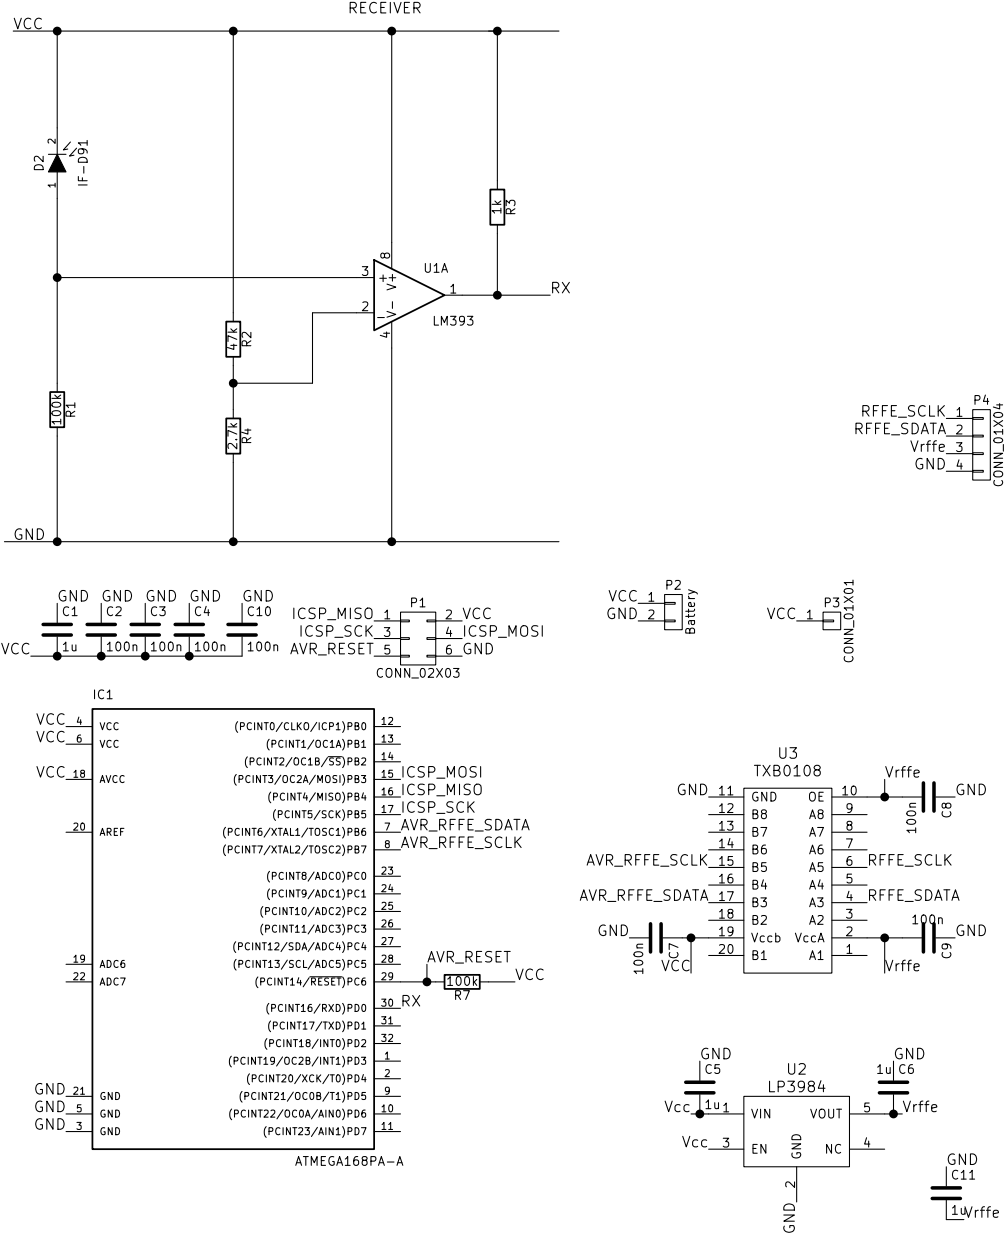
[picture p93: page 1]
