Denhart/uniProject9-10/mockups/002-monopole/measurements/2016-03-30-sweeping_capacitors/efficiency_side.pdf

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

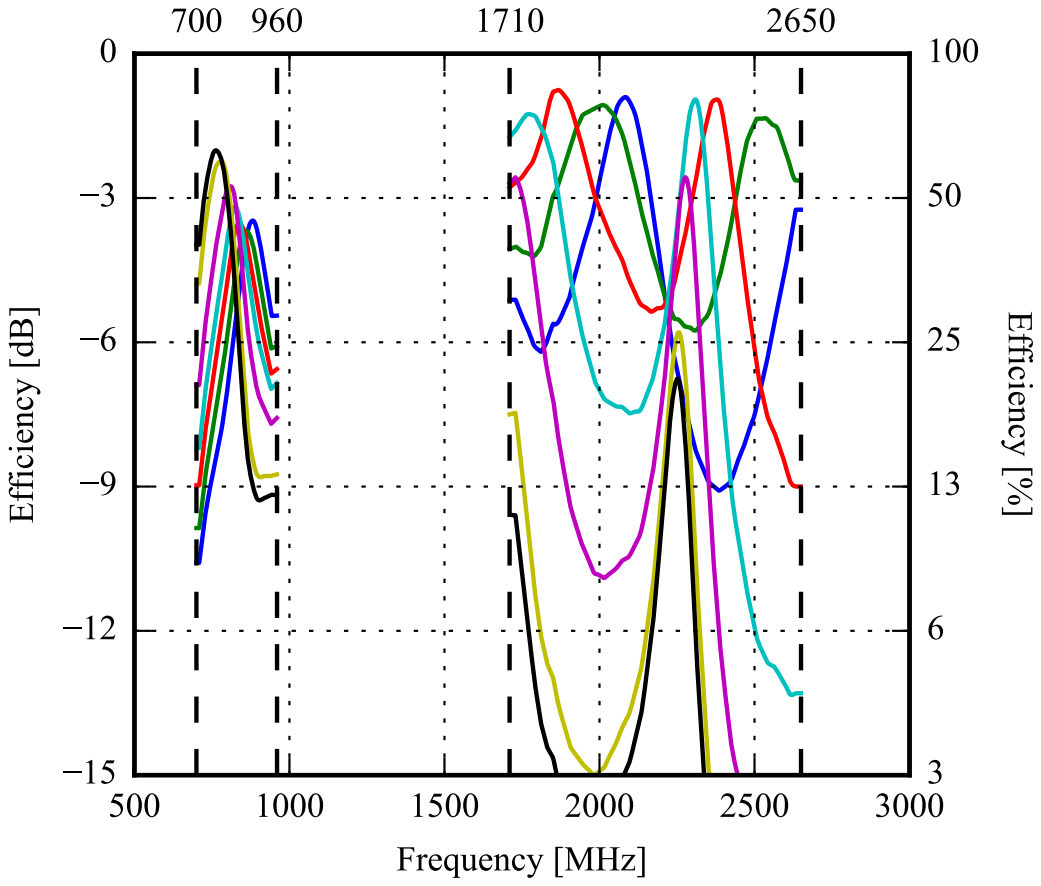
[picture p96: page 1]
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
