Denhart/uniProject9-10/mockups/001-trianglefeed/measurements/2016-02-26-sparameters_and_efficiency/sparams.pdf

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

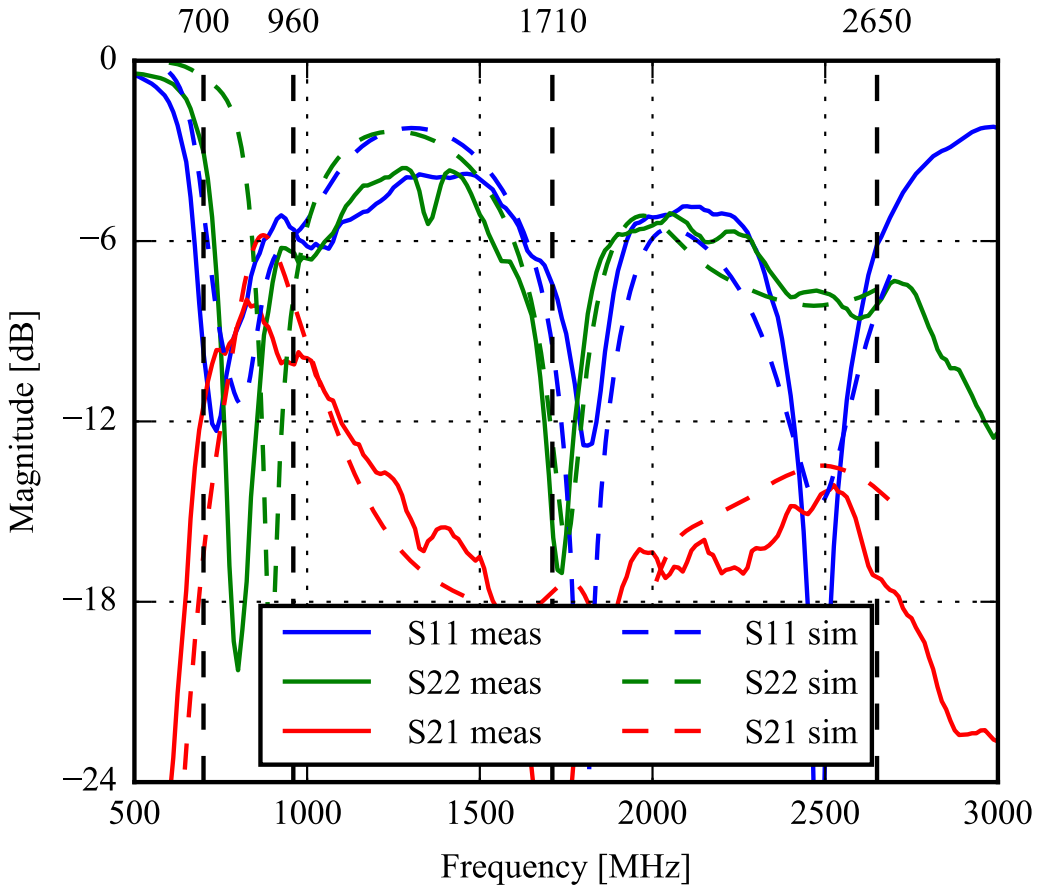
[picture p102: page 1]
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
