Denhart/uniProject9-10/mockups/001-trianglefeed/measurements/2016-03-11-capacitor_sweep/s22_csh2.pdf

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

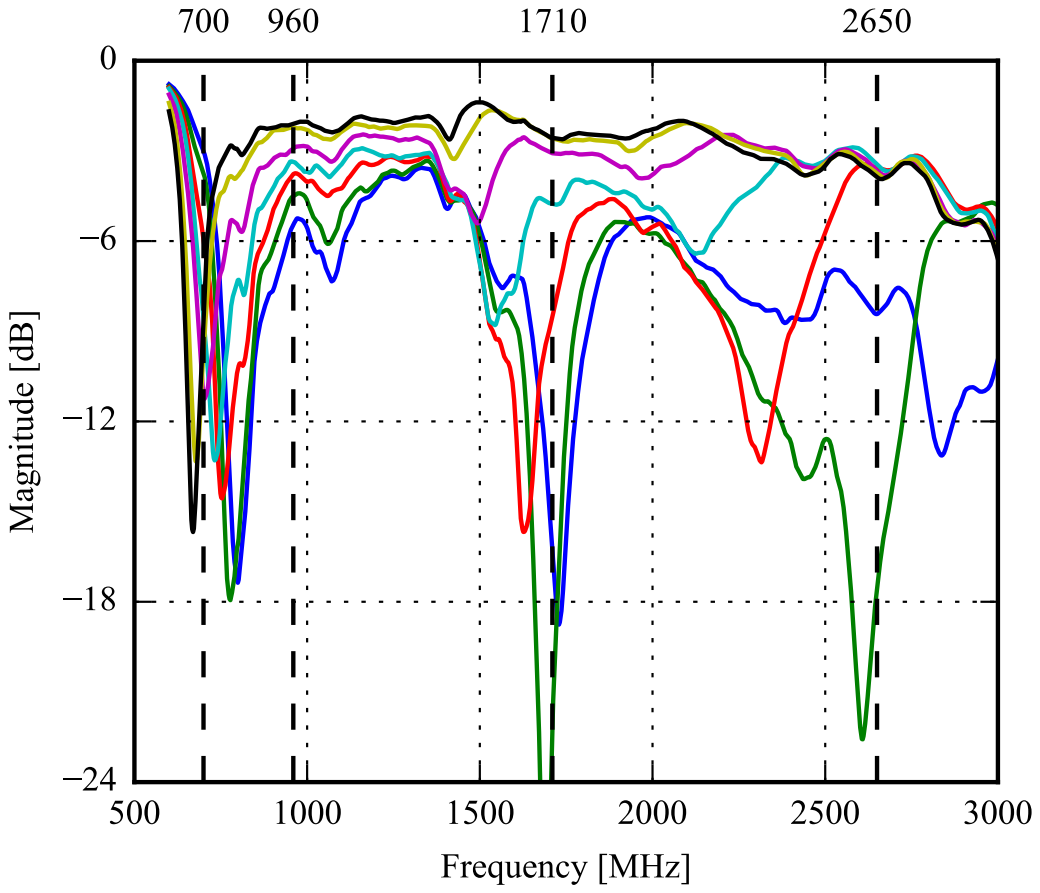
[picture p105: page 1]
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
