Denhart/uniProject9-10/mockups/002-monopole/measurements/2016-03-30-sweeping_capacitors/s22_csh2.pdf

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

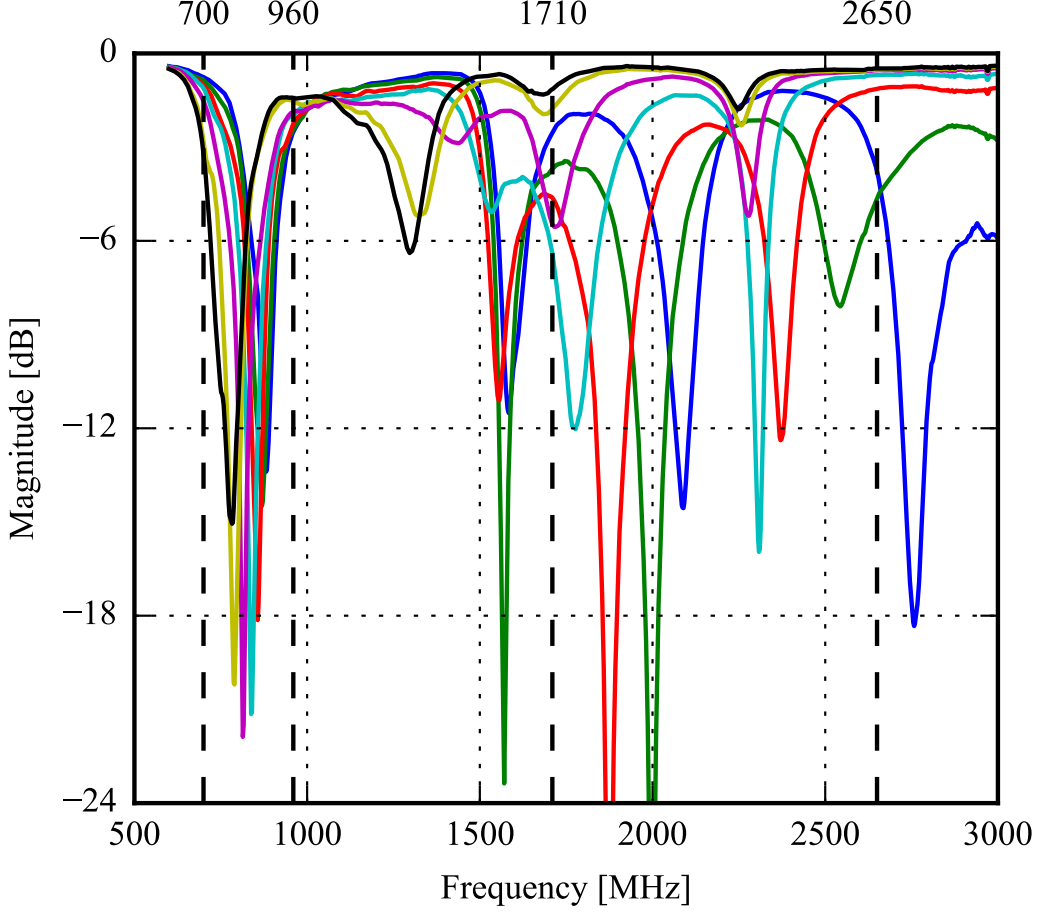
[picture p109: page 1]
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
