Denhart/uniProject9-10/sim/sn/018-transmission_line/results/w1_45mm.pdf

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

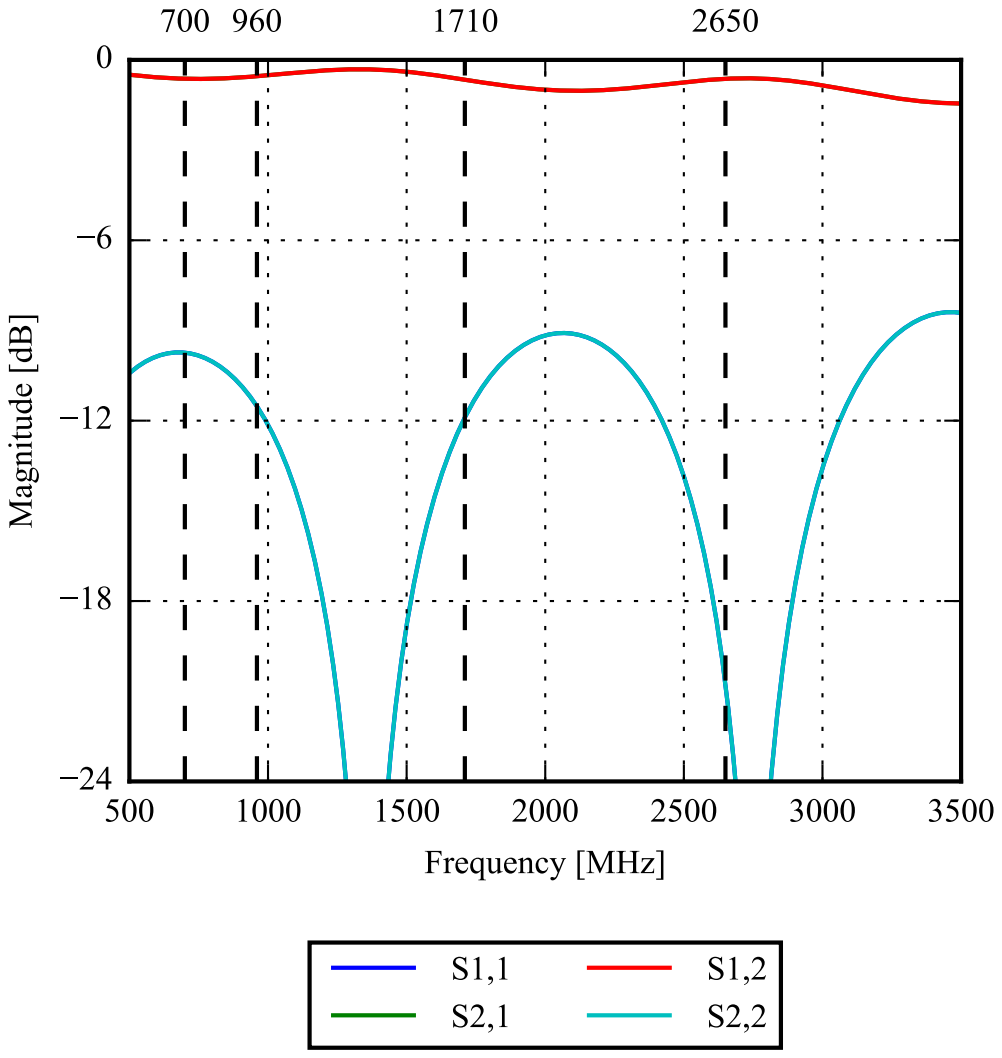
[picture p114: page 1]
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
