Denhart/uniProject9-10/pres/img/soren/ue/design2sn/example.pdf

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

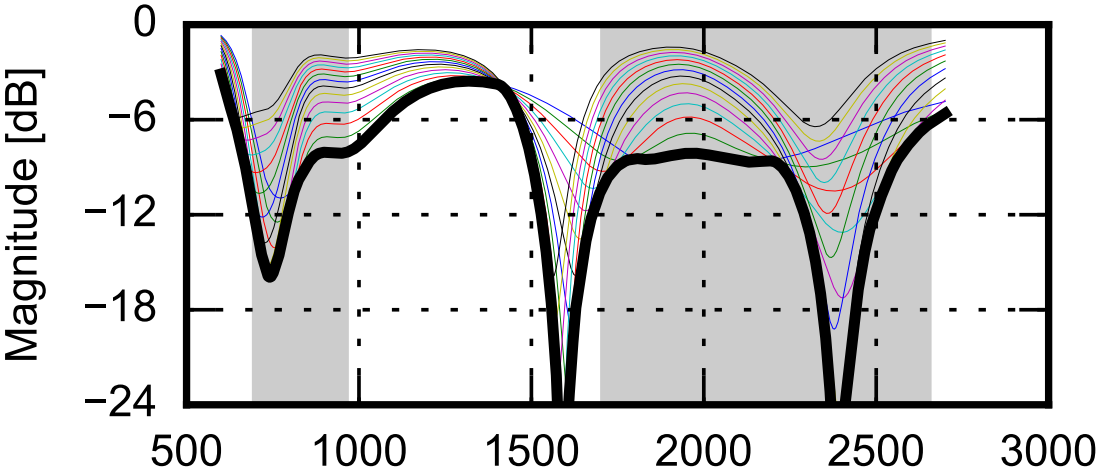
[picture p115: page 1]
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
