Denhart/uniProject9-10/pres/img/soren/proto/design1lt/effside.pdf

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

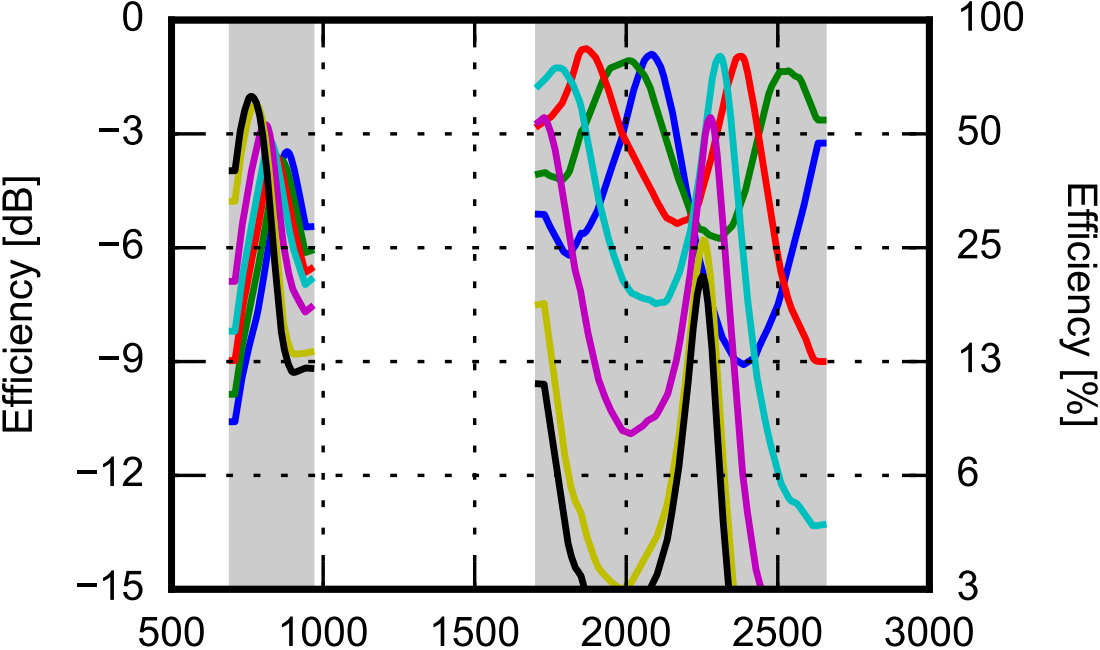
[picture p116: page 1]
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
