Denhart/uniProject9-10/pres/img/soren/proto/design2sn/effside.pdf

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

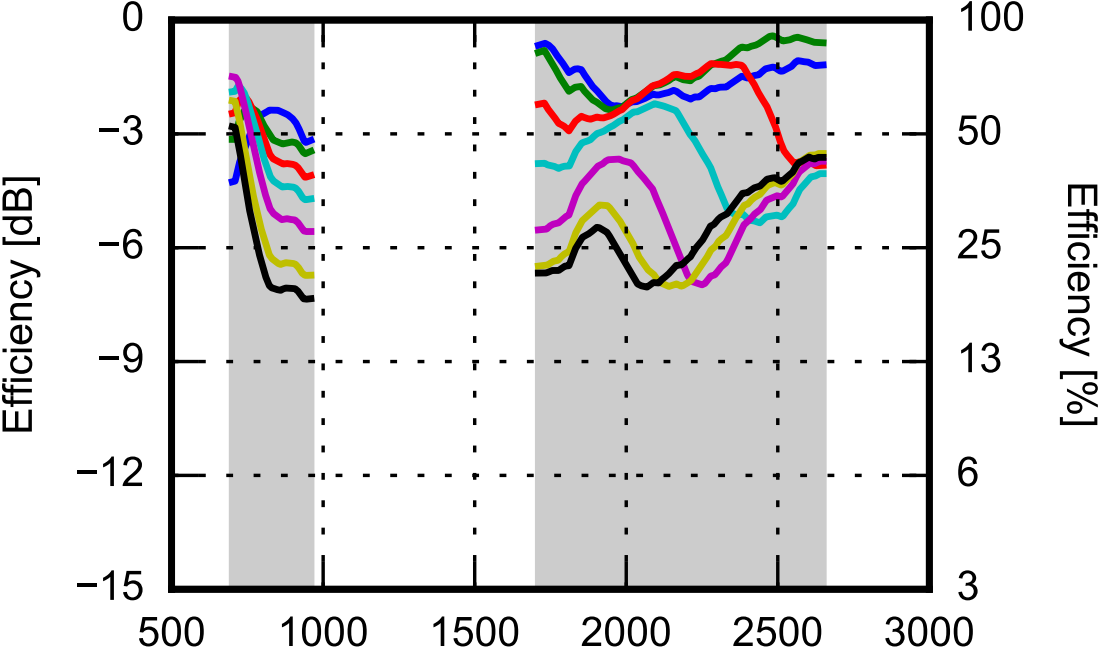
[picture p120: page 1]
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
