Denhart/uniProject9-10/pres/img/soren/ue/design3hv/s22side.pdf

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

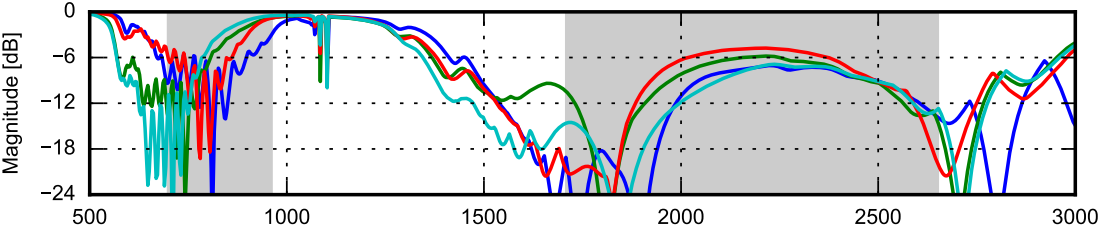
[picture p138: page 1]
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
