Denhart/uniProject9-10/mockups/001-trianglefeed/measurements/2016-02-24-matching_side_antenna/sparams/s22.pdf

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

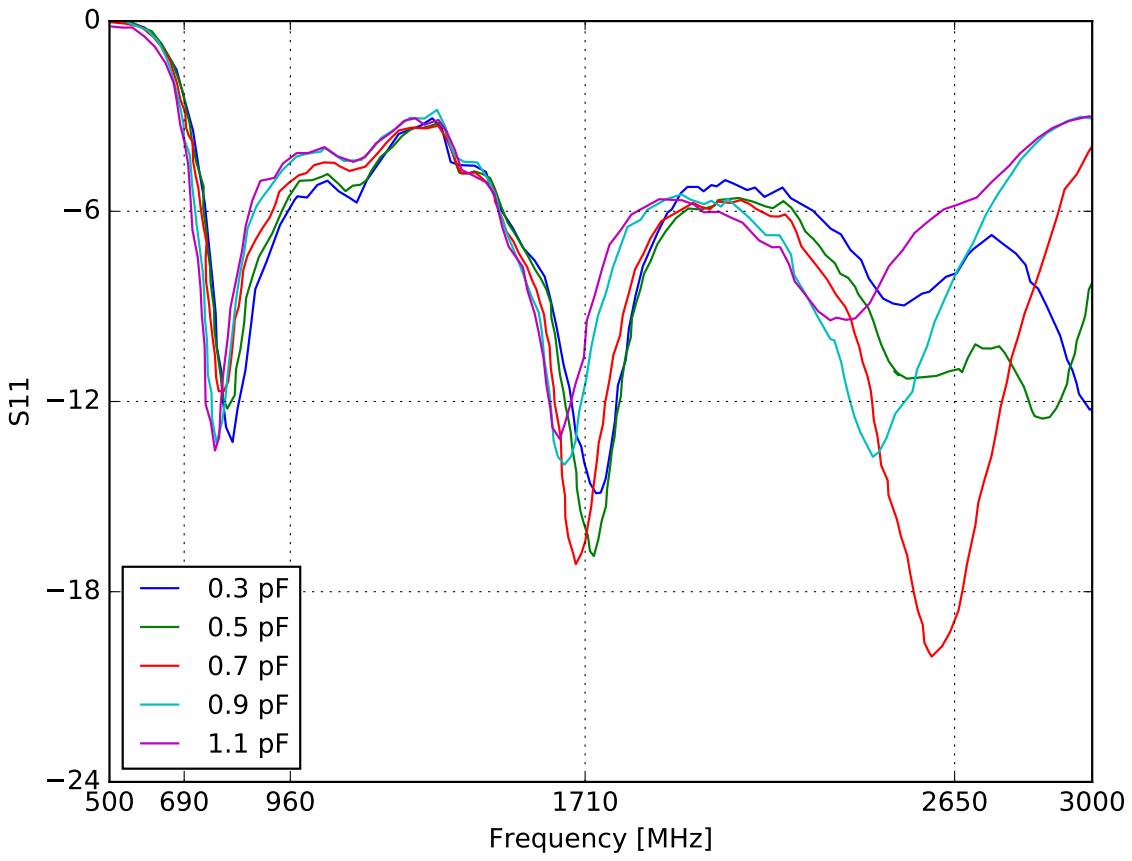
[picture p139: page 1]
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
