Denhart/uniProject9-10/mockups/001-trianglefeed/measurements/2016-02-23-matching_top_antenna/sparams/s11.pdf

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

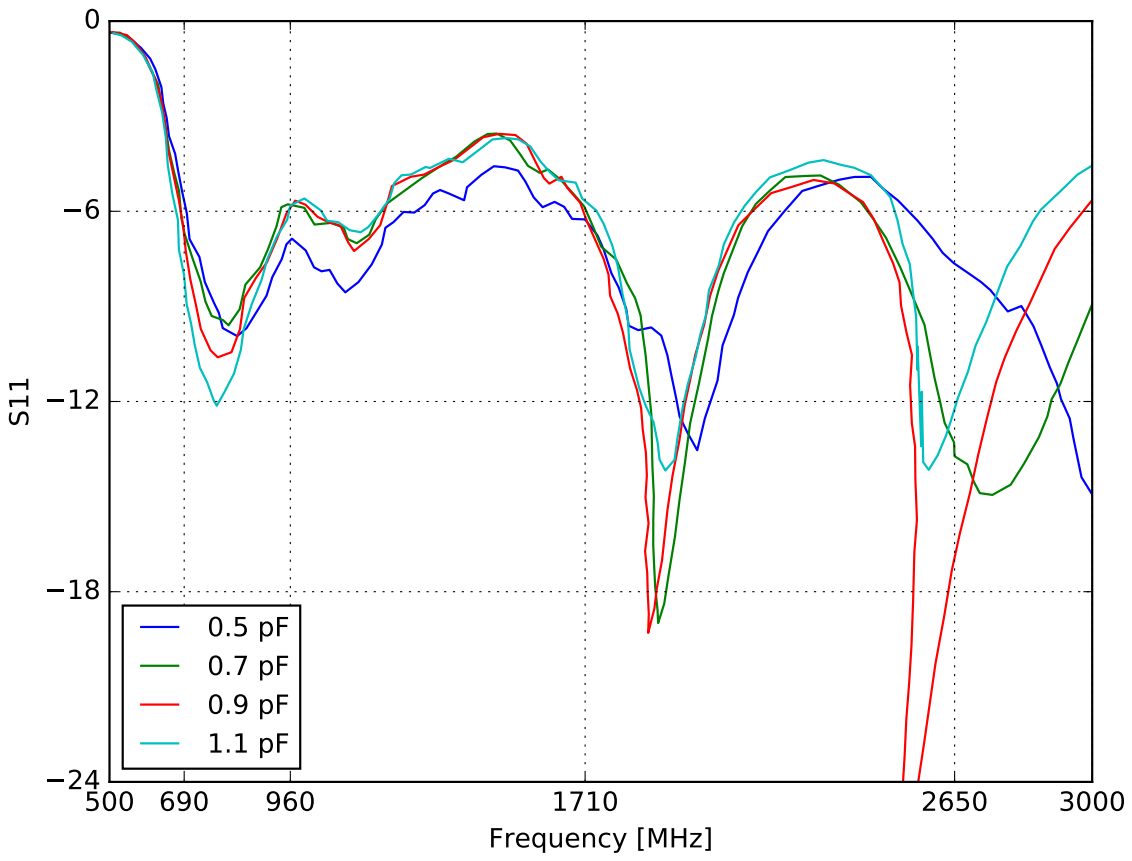
[picture p141: page 1]
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
