Denhart/uniProject9-10/mockups/001-trianglefeed/measurements/2016-02-23-matching_top_antenna/satimo/003-top-ant_eff.pdf

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

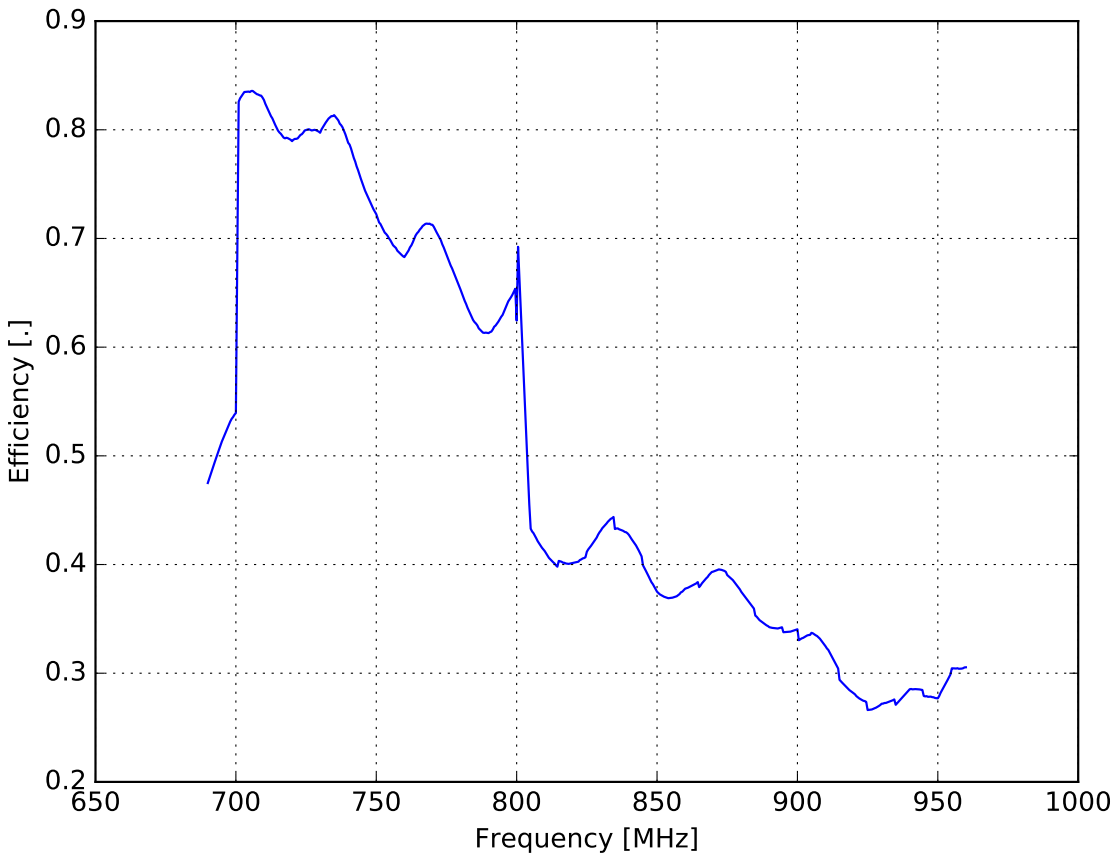
[picture p142: page 1]
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
