Denhart/uniProject9-10/sim/sn/014-ilvonen2014design/2016-01-26-no_user/EfficiencyAC2-Csh1.txt/efficiency-ac2-csh1.pdf

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

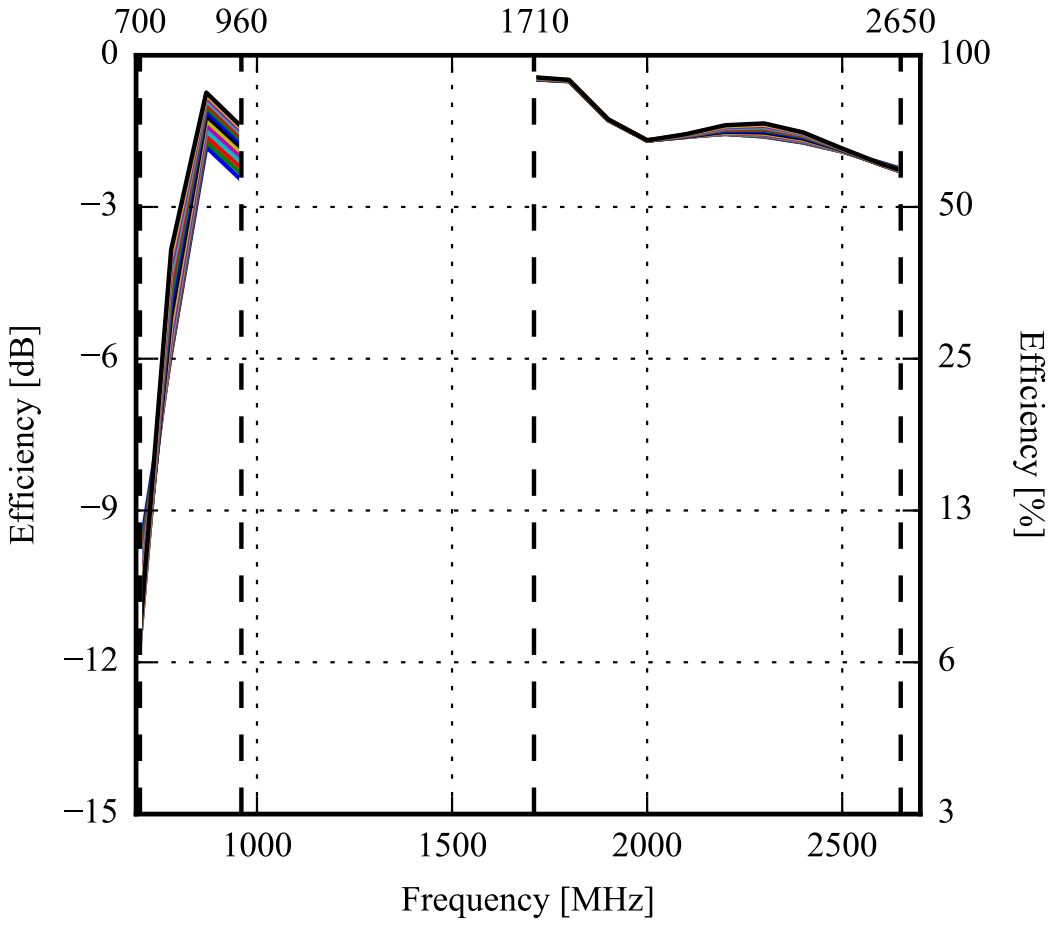
[picture p144: page 1]
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
