Denhart/uniProject9-10/sim/sn/014-ilvonen2014design/2015-12-15-user_effects/play_mode/correlation_Csh1-sweep.pdf

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

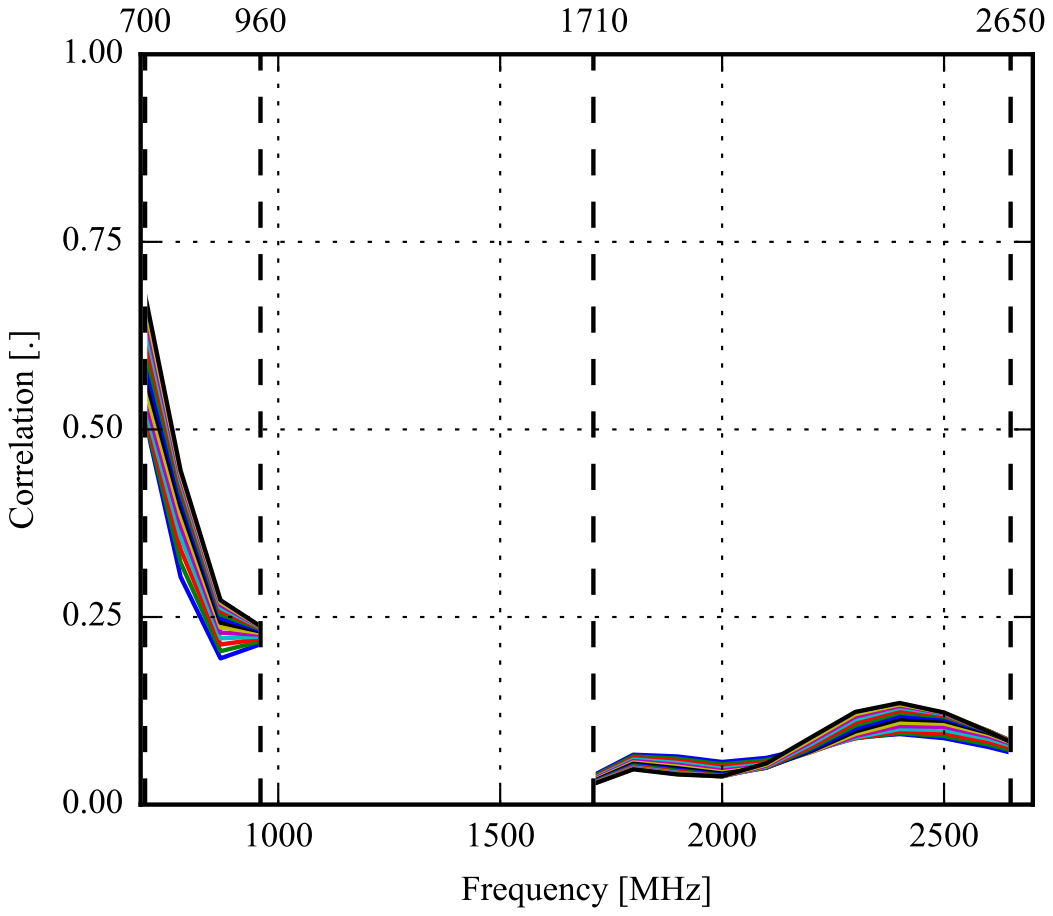
[picture p145: page 1]
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
