Denhart/uniProject9-10/(list of files, drawings)

Other design files:
sim/lt/ifa-v1/Model/3D/Model.dsn
