Denhart/uniProject9-10/hw/pcb/antenna_side2/serial_optical_adaptor.kicad_pcb

## KiCad design hw/pcb/antenna_side2/serial_optical_adaptor.kicad_pcb (2016-05-02)

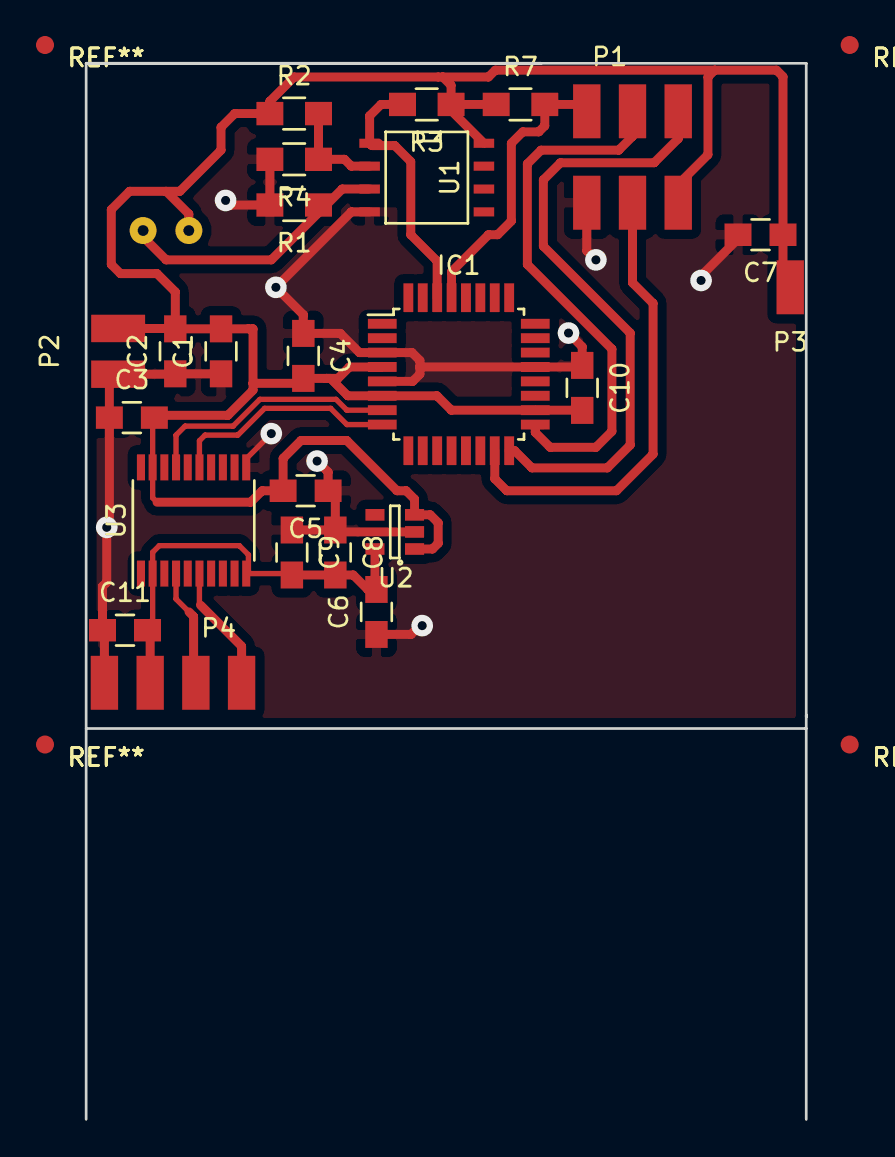
[picture p147: board serial_optical_adaptor.kicad_pcb from above]

Board: 2 copper layers, 40.0 x 58.7 mm, 25 parts (1 on the bottom side), 14 nets.

Parts:
C1, C2, C3, C4, C5, C6, C8, C10, C11: C; C_0805_HandSoldering
C7, C9: 0.1pF; C_0805_HandSoldering
D2: IF-D91
IC1: ATMEGA168PA-A; TQFP-32_7x7mm_Pitch0.8mm
P1: CONN_02X03; CONN_02X03_SMD
P2: Battery; Batt
P3: CONN_01X01; CONN_01X01_SMD
P4: CONN_01X04; CONN_01X04_SMD
R1, R7: 100k; R_0805_HandSoldering
R2: 47k; R_0805_HandSoldering
R3: 1k; R_0805_HandSoldering
R4: R; R_0805_HandSoldering
U1: LM393; SOIC-8-N
U2: LP3984; SOT-23-5
U3: TXB0108; TSSOP-20_4.4x6.5mm_Pitch0.65mm

Connections:
/AVR_RESET: IC1.29, P1.5, R7.2
/AVR_RFFE_SCLK: IC1.8, U3.15
/AVR_RFFE_SDATA: IC1.7, U3.17
/GND: C1.1, C2.1, C3.1, C4.1, C5.1, C6.1, C7.2, C8.1, C9.1, C10.1, C11.1, IC1.3, IC1.5, IC1.21, P1.6, P2.2, P4.4, R1.2, R4.2, U1.4, U2.2, U3.11
/ICSP_MISO: IC1.16, P1.1
/ICSP_MOSI: IC1.15, P1.4
/ICSP_SCK: IC1.17, P1.3
/RFFE_SCLK: P4.1, U3.6
/RFFE_SDATA: P4.2, U3.4
/RX: IC1.30, R3.2, U1.1
/VCC: C1.2, C2.2, C3.2, C4.2, C5.2, C7.1, C10.2, D2.2, IC1.4, IC1.6, IC1.18, P1.2, P2.1, P3.1, R2.1, R3.1, R7.1, U1.8, U2.1, U2.3, U3.19
/Vrffe: C6.2, C8.2, C9.2, C11.2, P4.3, U2.5, U3.2, U3.10
unnamed: D2.1, R1.1, U1.3
unnamed: R2.2, R4.1, U1.2
