Denhart/uniProject9-10/mockups/002-monopole/pcb/001-trianglefeed.kicad_pcb

## KiCad design mockups/002-monopole/pcb/001-trianglefeed.kicad_pcb (2016-03-15)

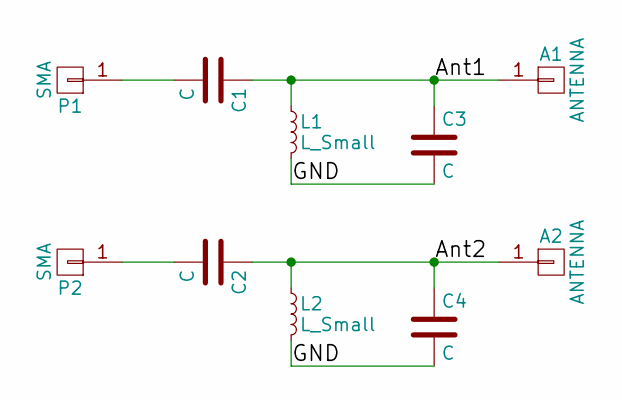
[picture p148: schematic 001-trianglefeed.sch]

Parts:
A1, A2: ANTENNA; Measurement_Point_Square-SMD-Pad_Small
C1, C2, C3, C4: C; C_0402
L1, L2: L_Small; C_0603_HandSoldering
P1, P2: SMA; Measurement_Point_Square-SMD-Pad_Small

Connections:
/Ant1: A1.1, C1.1, C3.1, L1.1
/Ant2: A2.1, C2.1, C4.1, L2.1
/GND: C3.2, C4.2, L1.2, L2.2
unnamed: C1.2, P1.1
unnamed: C2.2, P2.1

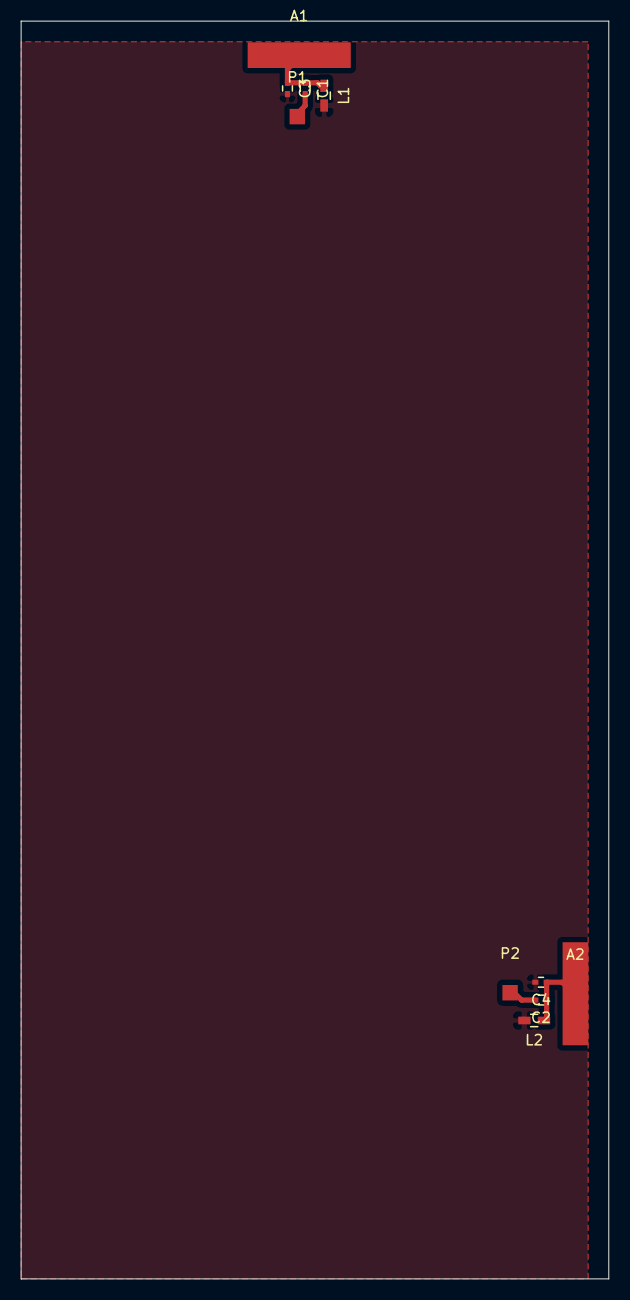
[picture p149: board 001-trianglefeed.kicad_pcb from above]

Board: 2 copper layers, 57.0 x 122.0 mm, 10 parts (0 on the bottom side), 5 nets.
