Denhart/uniProject9-10/(commit log)

2015-09-14 Added first crappy antenna
2015-09-27 Edge antenna.
2015-09-27 Ny antenna
2015-09-28 Edge antenna not working
2015-09-29 gi hals
    [Model.dsn]
2015-10-02 Samll (?) antenna
2015-10-04 Ground clearance+ == bandwidth+
2015-10-06 Nice antenna. Committing before changing.
2015-10-06 Neat, folded arm antenna for 2.1 GHz
2015-10-18 Added circuit diaram
2015-11-22 Redid CCE antenna
2015-11-24 Working on second antenna for the triangular-feed design
2015-11-26 Moved the antenna to a top-left configuration
2015-11-26 Nice dual antenna: Cover whole band with tunable second antenna
2015-11-26 Awesome antenna! Ant1: Covers all, Ant2: Tunable to cover all
2015-11-26 AWESOME ANTENNA: TUNABLE TO COVER ALL BANDS!
2015-11-27 ANTENNA SENT IN NOVEMBER MONTHLY REPORT
2015-11-27 Antenna for monthly report november
2015-12-03 ANTENNA FOR REPORT DOC
2015-12-04 Added test files for scripts
    [allSparams.txt]
2015-12-04 Changed plots to 0.3:0.2:2.9 pF range
    [sparams.txt]
2015-12-06 Section about triangle-feed antenna
2016-02-02 A tech_sol/nonresonant AM tech_sol/nonresonant/schematic_tuning.pdf AM tech_sol/nonresonant/technical.pdf
2016-02-08 VERSION OF TRIG ANTENNA USED IN REPORT
2016-02-15 Added pcb
2016-02-16 Measurement of antenna.
    [001-trianglefeed.kicad_pcb, 03_sparams.csv]
2016-02-23 Matching top antenna
2016-02-26 Eff meas
    [sparams.csv]
2016-03-11 Added svn :~)
    [03.csv, 03_sparams_cst.txt, 05.csv, 07.csv, 09.csv, 11.csv, octave_test_eff.csv]
2016-03-14 SAMS BOARD
    [samanthas_board.dxf]
2016-03-23 Updated introductions
    [s_params_cMax.txt]
2016-04-06 A hw/SMTU2032-1.kicad_mod A hw/adg3300.dcm A hw/lp3984.dcm A hw/lp3984.lib M hw/serial_optical_adaptor-cache.lib M hw/serial_optical_adaptor.bak M hw/serial_optical_adaptor.pro M hw/serial_optical_ad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
    [serial_optical_adaptor.sch]
2016-04-08 Updated values
    [avr_rffe_output.csv, serial_optical_adaptor.sch, uart_over_optical.csv]
2016-04-12 Scope measured
    [001-our_noconnect.csv, 002-our_connect.csv, 003-wispry_noconnect.csv, 004-wispry_connect.csv]
2016-04-19 Henriks measurements
    [component_update.ods]
2016-04-25 Working on capacity section
2016-04-26 Matching side antenna - not done
    [triag-match-samboard.ods]
2016-04-27 Fucking lorteantenne
    [triag-match-samboard.ods, triag-side-1.2_1.5_3.0.csv, triag-top_8.2_3.3_0.6.csv]
2016-05-03 Added meas
    [components.ods]
2016-05-05 A 006-lasse_with_tuner AM 006-lasse_with_tuner/S11.pdf AM 006-lasse_with_tuner/S21.pdf AM 006-lasse_with_tuner/S22.pdf AM 006-lasse_with_tuner/analyze_efficiency.py AM 006-lasse_with_tuner/analyze_sp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
    [components.ods]
2016-05-11 A 008-lasse_WA_with_tuner AM 008-lasse_WA_with_tuner/S11.pdf AM 008-lasse_WA_with_tuner/S21.pdf AM 008-lasse_WA_with_tuner/S22.pdf AM 008-lasse_WA_with_tuner/analyze_efficiency.py AM 008-lasse_WA_wit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
    [components.ods]
2016-05-16 Lasse double results
    [components.ods, lasse_03_03_03_03Ch1.csv, lasse_30_03_03_03Ch1.csv, lasse_30_30_03_03Ch1.csv, lasse_30_30_30_03Ch1.csv, lasse_30_30_30_30Ch1.csv]
2016-05-18 A 2016-05-18-opticalboard_vs_no-opticalboard/satimo A 2016-05-18-opticalboard_vs_no-opticalboard/satimo/antenna A 2016-05-18-opticalboard_vs_no-opticalboard/satimo/antenna/wonder-side-noOptical--HB-H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
    [wonder_no_opticalCh1.csv]
2016-05-18 Done with optical board doc
2016-05-19 Fingeren i døren
2016-05-24 Satimo chamber
2016-05-28 Således
    [sparamsCh1.csv]
2016-05-30 AM analysis/antenna_limitations.pdf D analysis/antenna_limitations.png
2016-06-21 AM henrik/schematic_tuning.pdf
2016-06-22 M henrik/schematic_tuning.pdf
